DanielFLopez1620/orion_common/README.md

# 🤖 ORION Commons

## 🌟 Overview

orion_welcome

This repository contains essential packages for the **O**pen-source **R**obot for **I**nteraction **O**bjectives and **N**avigation, also known as **ORION Project**, a ROS 2-based differential mobile robot designed for **Human-Robot Interaction (HRI)** applications.

**Keywords:** ROS 2, Differential Robot, HRI, ROS 2 Jazzy, Low-Cost Robotics.

> Note: This is a fork of the original version, which aims to check for updates as some time has passed by and also work on some pending bugs or functionalities. This may depend on my free time, so not sure how frequent the changes would be.

---

## 📝 License

The source code is released under a [BSD 3-Clause license](/LICENSE).

**Forked and maintained by:** [Daniel Felipe López Escobar](https://github.com/DanielFLopez1620)

**Originally developed by**: [Daniel Felipe López Escobar](https://github.com/DanielFLopez1620), [Miguel Ángel Gonzalez Rodriguez](https://github.com/miguelgonrod), and [Alejandro Bermúdez Fajardo](https://github.com/alexoberco).

The ORION Commons packages have been tested under [ROS](https://www.ros.org/) **Jazzy** distribution.

---

## 📚 Table of Contents

- [📦 Repository Summary](#-repository-summary)
- [🧩 Other Functionalities](#-other-functionalities)
- [📥 Installation](#-installation)
- [⚠️ Troubleshooting](#️-troubleshooting)

---

## 📦 Repository Summary

The repository is organized into modular ROS 2 packages:

- 🌌 **[`orion`](/orion/README.md)** 🛰️ Meta-package grouping all main components dependencies.
- 📦 **[`orion_assets`](/orion_assets/README.md)** 🗂️ CAD files for design, assembly, and construction of the robot.
- 🎮 **[`orion_control`](/orion_control/README.md)** 🧠 Configuration for controllers and hardware interfaces plugins for ROS 2 controllers.
- 🧩 **[`orion_description`](/orion_description/README.md)** 📐 URDF/Xacro description of the robot’s structure.
- 🏗️ **[`orion_base`](/orion_base/README.md)** 📦 Core logic and embedded codes of the ESP32s (mobile base and interaction) of the robot.
- 🚀 **[`orion_bringup`](/orion_bringup/README.md)** 🟢 Launch and startup configuration for the usage of the real robot.
- 🐳 **[`orion_docker`](/orion_docker/README.md)** 📦 Docker support for containerized development and deployment of the robot.
- 🧰 **[`orion_utils_py`](/orion_utils_py/README.md)** 🐍 Utility scripts in Python 3 to common applications like laser filter or simple actions.

To build you robot, review the hardware changes and learn about the versions of the robot, do not forget to check the 📖 [`ORION Wiki`](https://github.com/DanielFLopez1620/orion_common/wiki) 📔

---

## 🧩 Other Functionalities

These components provide extended capabilities for sensors, simulation, perception, and interaction:

- 🧿 **[`orion_gz`](https://github.com/Tesis-ORION/orion_gz)** 🏙️ Simulation of the robot in GZ Harmonic that integrates native plugins, bridges between ROS 2 and GZ with [`ros_gz_bridge`](https://github.com/gazebosim/ros_gz/tree/ros2/ros_gz_bridge), and the integration of [`ros2_control`](https://control.ros.org/) with [`gz_ros2_control`](https://github.com/ros-controls/gz_ros2_control).

- 📄 **[`orion_tools`](https://github.com/DanielFLopez1620/orion_tools)** 🔧 A collection of packages for using SLAM, Nav2 and teleoperation with the robot.

- 🌐 **[`orion_web_interface`](https://github.com/Tesis-ORION/orion_web_interface)** 🖥️ Tool that allows the control and visualization of the robot by using a [`Node.js`](https://nodejs.org/en) and [`Astro`](https://astro.build/) Web interface.

- 🎥 **[`depth_orbbec_astra`](https://github.com/Tesis-ORION/depth_orbbec_astra)** 🔵 Packages to use the ORBBEC Astra RGBD Cameras on ROS 2 Jazzy. In this project is used the [ASTRA S](https://store.orbbec.com/products/astra-s) model.

- 🎥 **[`depth_ydlidar_os30a`](https://github.com/Tesis-ORION/Depth_ydlidar_os30a)** 🔴 Package to use the [YDLIDAR OS30A](https://www.ydlidar.com/products/view/23.html) on ROS 2 Jazzy.

- 🎥 **[`depth_maixsense_a010`](https://github.com/DanielFLopez1620/depth_maixsense_a010)** 🟢 Packages for the [Maixsense A010 Depth Camera](https://wiki.sipeed.com/hardware/en/maixsense/maixsense-a010/maixsense-a010.html) to work on ROS 2 Jazzy.

---

## 📥 Installation

Let's prepare us to use the robot, this installation is required for both your PC and the robot's Raspberry Pi. However, there would be additional steps you will need to follow on the robot, more info on [orion_bringup](/orion_bringup/README.md)

For now, follow these steps to install and build the project on ROS 2 Jazzy:

0. Make sure you have `colcon` installed:

    ~~~bash
    sudo apt update
    sudo apt install python3-colcon-common-extensions -y
    ~~~

1. Create your workspace:

    ~~~bash
    mkdir -p ~/ros2_ws/src
    cd ~/ros2_ws
    colcon build
    ~~~

2. Install the repository of ORION common in the source directory

    ~~~bash
    cd ~/ros2_ws/src
    git clone https://github.com/DanielFLopez1620/orion_common.git
    ~~~

3. Install the drivers packages for the cameras and the LD19 LIDAR.

    ~~~bash
    cd ~/ros2_ws/src
    git clone https://github.com/DanielFLopez1620/depth_maixsense_a010.git
    git clone https://github.com/Tesis-ORION/Depth_ydlidar_os30a.git
    git clone https://github.com/Tesis-ORION/depth_orbbec_astra.git

    # LD19 LIDAR driver — use main branch only (no per-distro branches exist).
    # The SDK is a git submodule, so --recurse-submodules is required.
    git clone --branch main --recurse-submodules \
        https://github.com/Myzhar/ldrobot-lidar-ros2.git
    ~~~

4. Implement the additional installs recommended on the cameras READMEs, for more info check [Maixsense A010](https://github.com/DanielFLopez1620/depth_maixsense_a010), [YDLidar OS30A](https://github.com/Tesis-ORION/Depth_ydlidar_os30a) and [ORBBEC ASTRA S](https://github.com/Tesis-ORION/depth_orbbec_astra) packages.

    ~~~bash
    # --------- General
    sudo usermod -a -G dialout $USER

    # -------- OS30A
    sudo ln -sf /lib/x86_64-linux-gnu/libdc1394.so /usr/lib/libdc1394.so.22

    # --------- ASTRA S
    sudo apt install libgflags-dev nlohmann-json3-dev  \
    ros-$ROS_DISTRO-image-transport  ros-${ROS_DISTRO}-image-transport-plugins ros-${ROS_DISTRO}-compressed-image-transport \
    ros-$ROS_DISTRO-image-publisher ros-$ROS_DISTRO-camera-info-manager \
    ros-$ROS_DISTRO-diagnostic-updater ros-$ROS_DISTRO-diagnostic-msgs ros-$ROS_DISTRO-statistics-msgs \
    ros-$ROS_DISTRO-backward-ros libdw-dev
    ~~~

5. Install all the dependencies:

    ~~~bash
    sudo apt update
    sudo apt install python3-rosdep -y
    cd ~/ros2_ws
    sudo rosdep init
    rosdep update
    rosdep install --from-paths src --ignore-src -r -y
    ~~~

6. After the installation is complete, build the package with the provided options to avoid errors with other packages in development:

    ~~~bash
    cd ~/ros2_ws
    colcon build --symlink-install --packages-select orion orion_description orion_control
    source install/setup.bash
    ~~~

7. You are ready to explore the usage of the robot on this PC, now proceed with the robot [bringup](/orion_bringup/README.md)

---

## ⚠️ Troubleshooting

Explore the different packages to check solutions to common problems found during the development of the project, considering the next:

- **orion_base:** Cases in terms of the embedded codes of the ESP32, µ-ROS, electronic connections and hardware specifications.
- **orion_bringup:** In terms of the startup application of the robot and the bringup of the robot.
- **orion_control:** For problems related with the plugins for the hardware interfaces of the controllers and general params of the controllers.
- **orion_description:** Cases related with the description model, changes of macros and params of actuators/controllers.

If you present another problem, propose it on the **[Issues](https://github.com/DanielFLopez1620/orion_common/issues)** of this repository.

---
