DanielFLopez1620/orion_common/orion/README.md

# 🤖 ORION

## 🖼️ Meet ORION

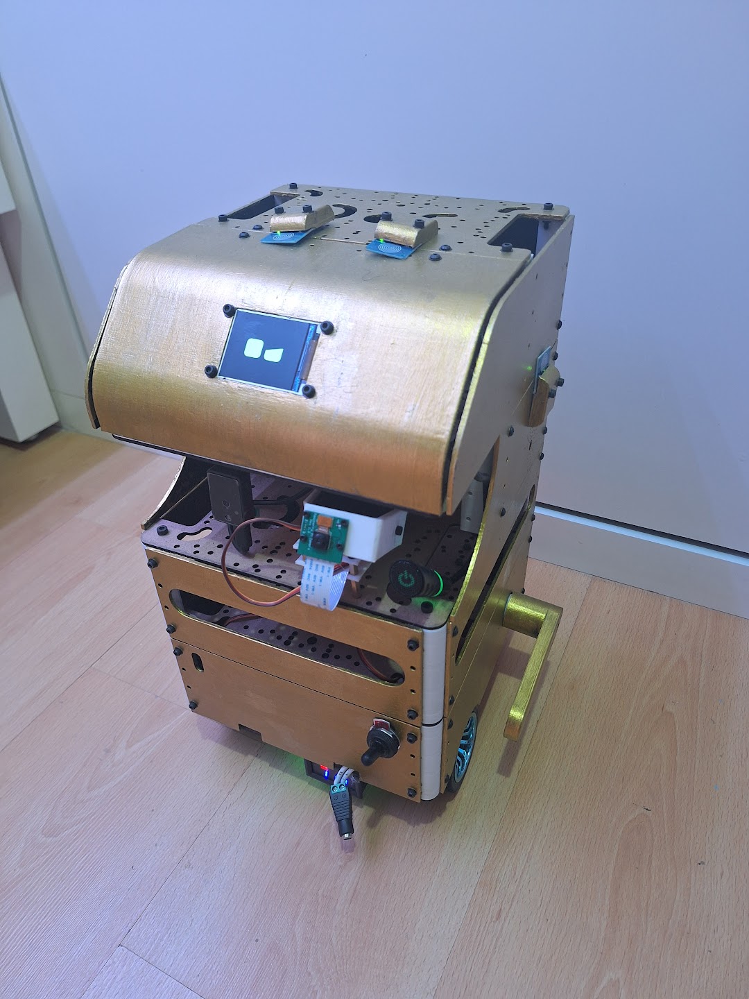
[picture p1: orion/img/orion_is_here.jpg]
orion_is_here


## 🌟 Overview

Meta-package that aggregates all core **ORION Common** packages — the **O**pen-source **R**obot for **I**nteraction **O**bjectives and **N**avigation. ROS 2 Jazzy differential robot designed for Human-Robot Interaction (HRI) applications.

---

## 📚 Table of Contents

- [📦 Core Packages](#-core-packages)
- [🚀 Quick Start](#-quick-start)
- [📖 Documentation](#-documentation)
- [🖼️ Meet ORION](#️-meet-orion)

---

## 📦 Core Packages

This meta-package ensures all dependencies are available:

- **[orion_description](/orion_description/README.md)** — URDF/Xacro robot model, mesh files, and description launch files
- **[orion_control](/orion_control/README.md)** — ROS 2 controllers and hardware interfaces (DiffDrive, Forward Command)
- **[orion_bringup](/orion_bringup/README.md)** — Startup configurations, udev rules, and systemd service
- **[orion_base](/orion_base/README.md)** — ESP32 embedded firmware (micro-ROS and serial implementations)
- **[orion_utils_cpp](/orion_utils_cpp/README.md)** — CPP utility codes (demos, laser filter, emotion display)
- **[orion_utils_py](/orion_utils_py/README.md)** — Python utility scripts (demos, laser filter, emotion display, g_mov module and related scripts)
- **[orion_assets](/orion_assets/README.md)** — CAD files, STL meshes, and fabrication resources
- **[orion_docker](/orion_docker/README.md)** — Containerized development and deployment environments

---

## 🚀 Quick Start

1. **Installation:** Follow the main [README](/README.md) for setup instructions.
2. **Hardware:** Check the [Wiki](https://github.com/DanielFLopez1620/orion_common/wiki) for robot construction and schematics.
3. **Examples:** See [orion_utils_py](/orion_utils_py/README.md) for demo scripts.

---

## 📖 Documentation

- **[Main README](/README.md)** — Full installation and troubleshooting guide
- **[CONTRIBUTING.md](/CONTRIBUTING.md)** — Code standards, branch naming, and PR guidelines
- **[Wiki](https://github.com/DanielFLopez1620/orion_common/wiki)** — Hardware, assembly, and detailed tutorials

---
