DanielFLopez1620/orion_common/orion_assets/README.md

# 🤖 ORION Assets

## 🌟 Overview

This directory contains the related files for the design, manufacturing and fabrication of the ORION robot.
If you want to build the robot, check the ⚙️[`Robot Construction`](https://github.com/Tesis-ORION/orion_common/wiki/Building-your-own-ORION-robot)🔧 on the Wiki.

---

## 📝 License

The CAD files (referred to the FreeCAD assets, meshes and drawings) are released under the Creative Commons Attribution-NonCommercial 4.0 International ([CC BY-NC 4.0](/orion_assets/LICENSE))

**Maintainer**: [Daniel Felipe López Escobar](https://github.com/DanielFLopez1620).

---

## Content

You can find the next information and files:

- **[3DPrintAssets:](/orion_assets/3DPrintAssets/README.md)** It is a collection of assets in STL so you can pass the files to your slicer and start building the ORION robot.

- **[FreeCadAssets:](/orion_assets/FreeCadAssets/README.md)** They are the source CAD of the project, so if you want to make modifications or take a look of the pieces you can do it freely by using *FreeCad 1.0.0*.

- **[laserAssets:](/orion_assets/LasserAssets/README.md)** Another option to create some parts of ORION is by using laser cuts on MDF, acrylic or similar materials. This only applies to bases and walls.

- **[calc_inertia.py:](/orion_assets/calc_inertia.py)** It is a file oriented to obtain the inertia of STL and URDF by providing the object path, the scale and the mass.
