DanielFLopez1620/orion_common/orion_assets/LasserAssets/README.md

# Laser Assets

This directory contains the drawing files for the parts intended to be cut with Laser. They were exported by using **FreeCAD**.

## Preparations

To build your ORION robot, you can cut the pieces over acrylic, MDF or similar materials with a thickness between 3 mm to 6 mm, depending on the material and the endurance you want. You require an area of material between 1 m² to 1.5 m².

The .dxf extension files were provided as they are the most common ones that are asked when going to a workshop to cut pieces. If your require other formats, please refer to **[FreeCadAssets](/orion_assets/FreeCadAssets/README.md)**, search the pieces you need and convert them to the desired format.

### Required pieces to build ORION 1.3.x to 1.6.x

You will require the next pieces:

| Name | Quantity | Info |
|---|---|---|
| [Battery Holder Support](/orion_assets/LasserAssets/bathold_support.dxf)  | 2 | To mount the battery holders |
| [Complete Platform](/orion_assets/LasserAssets/com_plate_template.dxf) | 4 | Complete level structure of the robot |
| [Half Platform](/orion_assets/LasserAssets/half_plate_template.dxf) | 2 | Half level structure of the robot |
| [Wall Batteries](/orion_assets/LasserAssets/wall_batteries.dxf) | 1 | Front wall that allows charger and switch placement |
| [Wall Curve Speaker](/orion_assets/LasserAssets/wall_curve_speaker.dxf) | 2 | Curve wall when using RPi4 Speakers |
| [Wall Curve](/orion_assets/LasserAssets/wall_curve.dxf) | 2 | Curve wall when using RPi5 |
| [Wall Front Lidar](/orion_assets/LasserAssets/wall_flidar.dxf) | 2 | Front/back wall for LIDAR scanning space |
| [Wall Lateral Lidar](/orion_assets/LasserAssets/wall_llidar.dxf) | 2 | Lateral walls for LIDAR scanning space |
| [Wall Regulator](/orion_assets/LasserAssets/wall_regulator.dxf) | 1 | Back wall that allows check of the regulator |
| [Wall Raspberry Pi](/orion_assets/LasserAssets/wall_rpi.dxf) | 1 | Back wall for RPi HMDIs and aux connections |
| [Wall Screen](/orion_assets/LasserAssets/wall_screen.dxf) | 2 | Wall that allow the form of the screen |
| [Wall Servo](/orion_assets/LasserAssets/wall_servo.dxf) | 2 | Lateral wall where the arms are placed |
| [Wall Stereo](/orion_assets/LasserAssets/wall_stereo.dxf) | 1 | Back wall when using RPi5 speaker |
