DanielFLopez1620/orion_common/orion_assets/FreeCadAssets/assembly_orion_full.FCStd

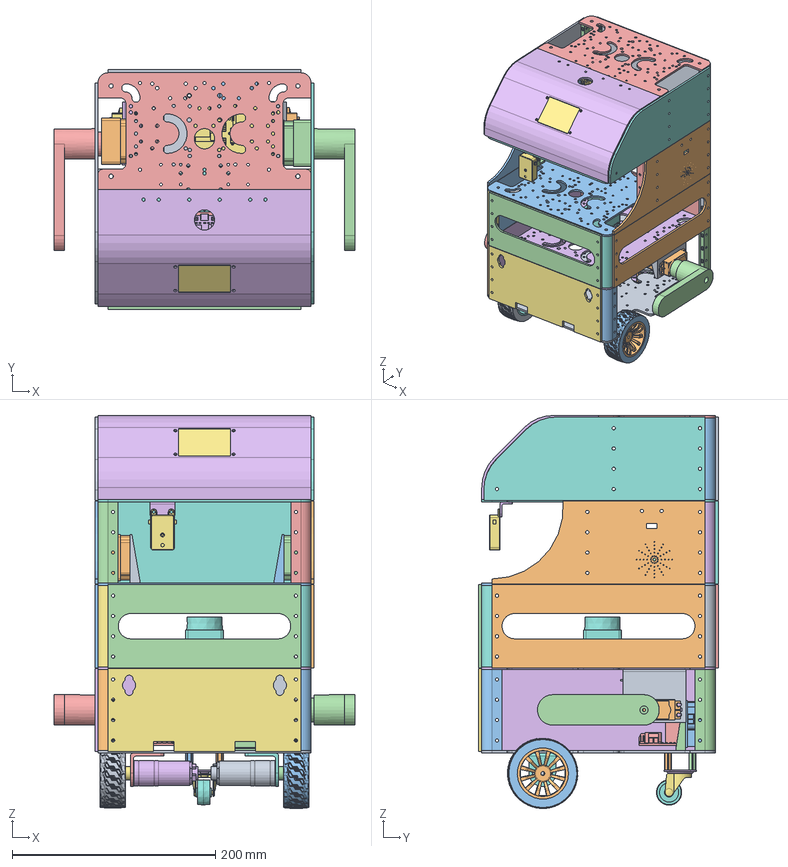
[picture p4: CAD file, 2026-07-29]
orion_assets/FreeCadAssets/assembly_orion_full.FCStd
296.0 x 236.0 x 387.1 mm
com_plate_template_com_plate_template_001
spacer_10x80_Body_001
spacer_10x80_Body_002
spacer_10x80_Body_003
spacer_10x80_Body_004
com_plate_template_com_plate_template_002
spacer_10x80_Body_005
spacer_10x80_Body_006
spacer_10x80_Body_007
spacer_10x80_Body_008
com_plate_template_com_plate_template_003
spacer_10x80_Body_009
spacer_10x80_Body_010
spacer_10x80_Body_011
spacer_10x80_Body_012
com_plate_template_com_plate_template_004
spacer_10x80_Body_013
spacer_10x80_Body_014
spacer_10x80_Body_015
spacer_10x80_Body_016
com_plate_template_half_plate_template001_001
screen_support_ScreenSupport_001
screen_il9225_screen_il9225_001
wall_lateral_template_wall_screen_001
wall_lateral_template_wall_screen_002
wall_lateral_template_wall_llidar_001
wall_lateral_template_wall_llidar_002
wall_frontal_template_wall_flidar_001
wall_frontal_template_wall_flidar_002
wall_lateral_template_wall_servo_002
wall_frontal_template_wall_batteries_001
wall_frontal_template_wall_fdefault_001
wall_frontal_template_wall_raspberry_001
wall_lateral_template_wall_curve_speaker_001
wall_lateral_template_wall_curve_speaker_002
simple_arm_simple_arm_001
simple_arm_simple_arm_002
maixsense_support_maixsense_sup_001
sipeed_a010_MaixsensA010_001
motor_mount_MotorMount_001
dc_motor_wenc_MotorDCwEnc_001
ring_Ring_001
neumatic_Neumatic_001
coupling_Coupling_001
motor_mount_MotorMount_002
dc_motor_wenc_MotorDCwEnc_002
coupling_Coupling_002
ring_Ring_002
neumatic_Neumatic_002
spacer_m4x17_spacer_m4x17_001
spacer_m4x17_spacer_m4x17_002
spacer_m4x17_spacer_m4x17_003
spacer_m4x17_spacer_m4x17_004
caster_wheel_p1_CasterBase_001
caster_wheel_p2_CasterWheelP2_001
caster_wheel_p3_CasterWheelP3_001
speaker_support_speaker_support_001
mini_speaker_mini_speaker_001
speaker_support_speaker_support_002
mini_speaker_mini_speaker_002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
