DanielFLopez1620/orion_common/orion_assets/FreeCadAssets/regulator.FCStd

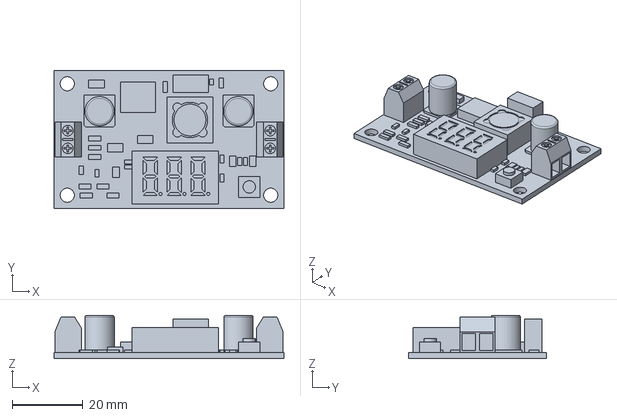
[picture p7: CAD file, 2026-07-29]
orion_assets/FreeCadAssets/regulator.FCStd
65.0 x 39.0 x 12.2 mm
