DanielFLopez1620/orion_common/orion_assets/LasserAssets/wall_screen.dxf

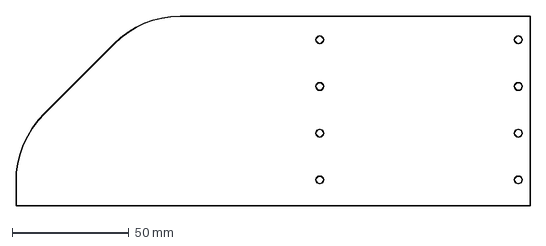
[picture p8: CAD file, 2025-11-06]
orion_assets/LasserAssets/wall_screen.dxf
220.0 x 81.0 mm
