DanielFLopez1620/orion_common/orion_description/meshes/picam_sup.stl

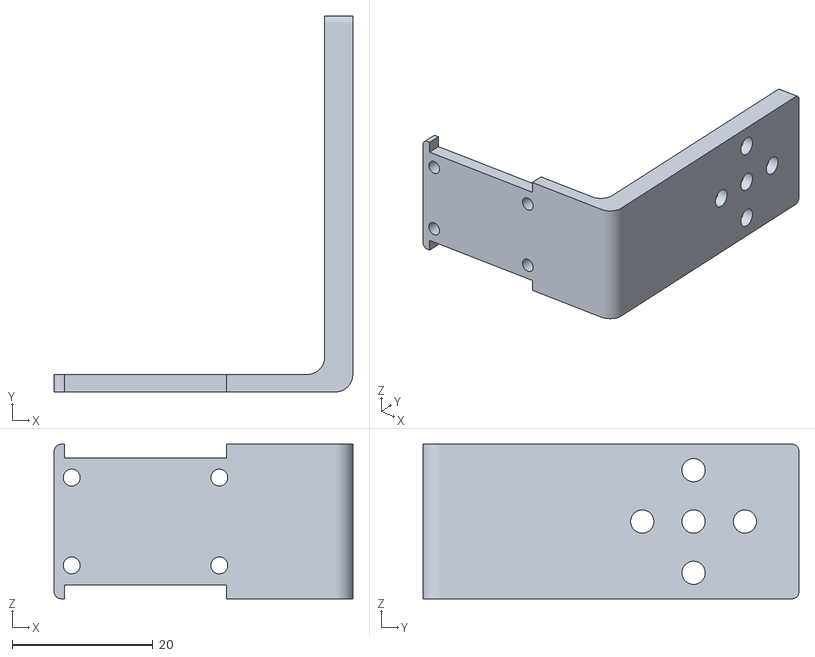
[picture p9: CAD file, 2026-07-29]
orion_description/meshes/picam_sup.stl
42.5 x 53.5 x 22.0
