DanielFLopez1620/orion_common/orion_assets/3DPrintAssets/orion_toy_cuboid.stl

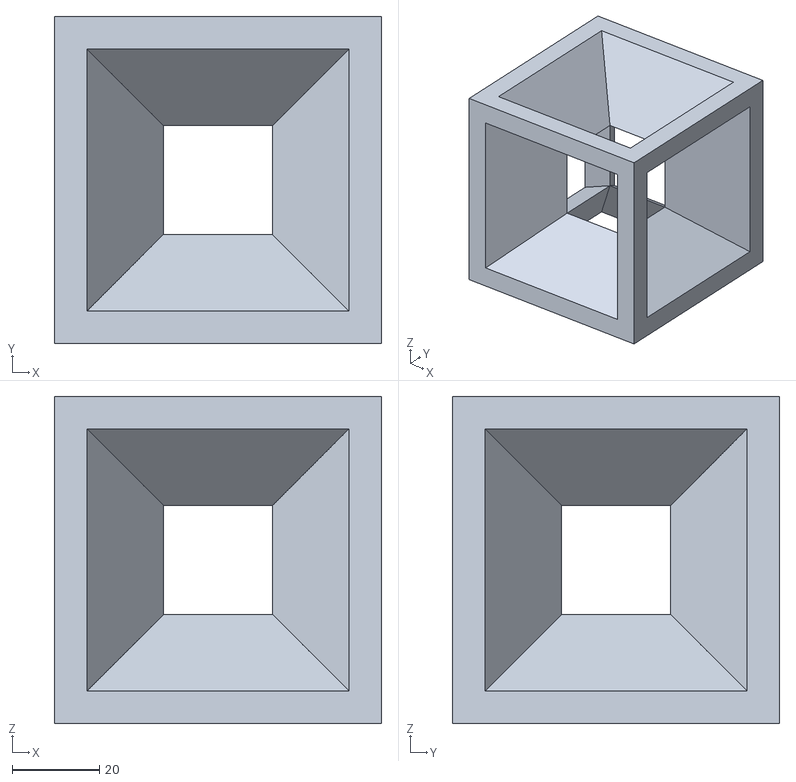
[picture p10: CAD file, 2025-11-06]
orion_assets/3DPrintAssets/orion_toy_cuboid.stl
75.0 x 75.0 x 75.0
