DanielFLopez1620/orion_common/orion_assets/FreeCadAssets/spacer_m3x10.FCStd

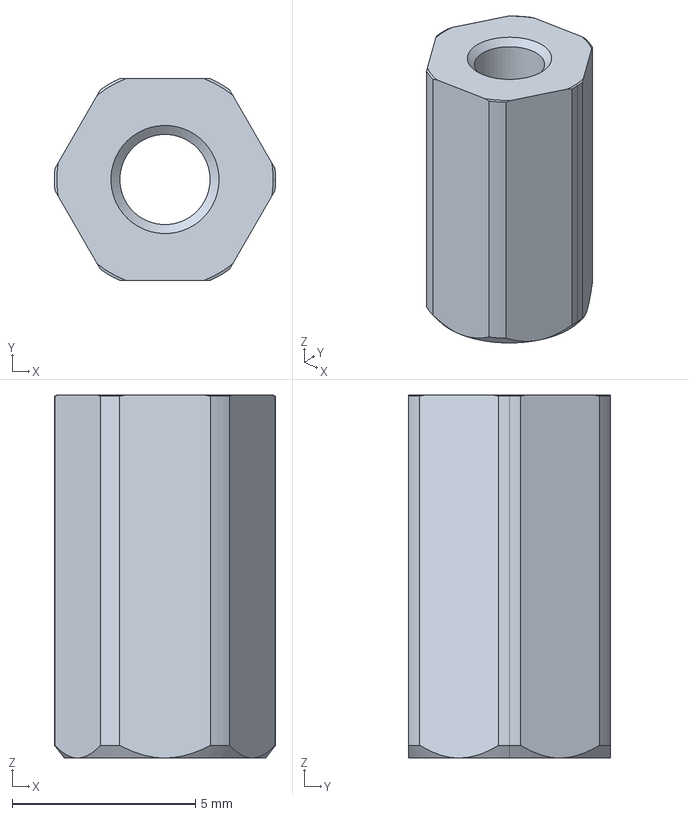
[picture p11: CAD file, 2026-07-29]
orion_assets/FreeCadAssets/spacer_m3x10.FCStd
6.03 x 5.50 x 9.90 mm
