DanielFLopez1620/orion_common/orion_assets/LasserAssets/wall_stereo.dxf

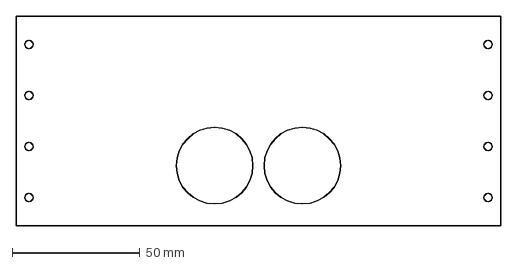
[picture p12: CAD file, 2025-11-06]
orion_assets/LasserAssets/wall_stereo.dxf
190.0 x 82.0 mm
