DanielFLopez1620/orion_common/orion_description/meshes/accel.stl

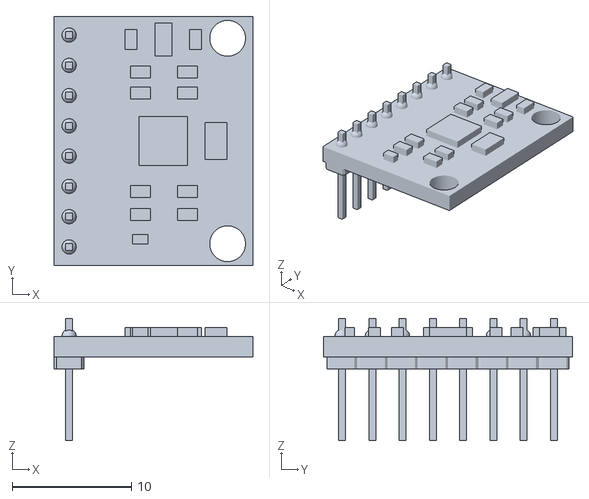
[picture p13: CAD file, 2026-07-29]
orion_description/meshes/accel.stl
16.7 x 20.9 x 10.2
