DanielFLopez1620/orion_common/orion_assets/FreeCadAssets/caster_wheel_p2.FCStd

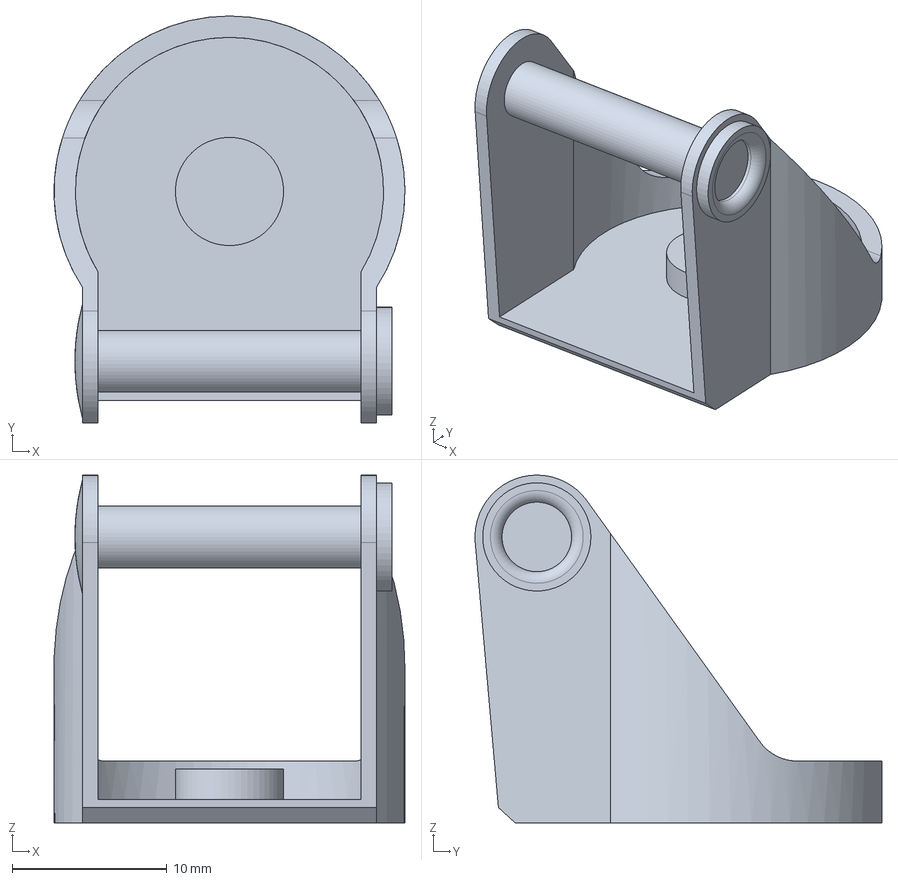
[picture p15: CAD file, 2026-07-29]
orion_assets/FreeCadAssets/caster_wheel_p2.FCStd
22.7 x 26.3 x 22.5 mm
