DanielFLopez1620/orion_common/orion_assets/3DPrintAssets/screen_support_h1.stl

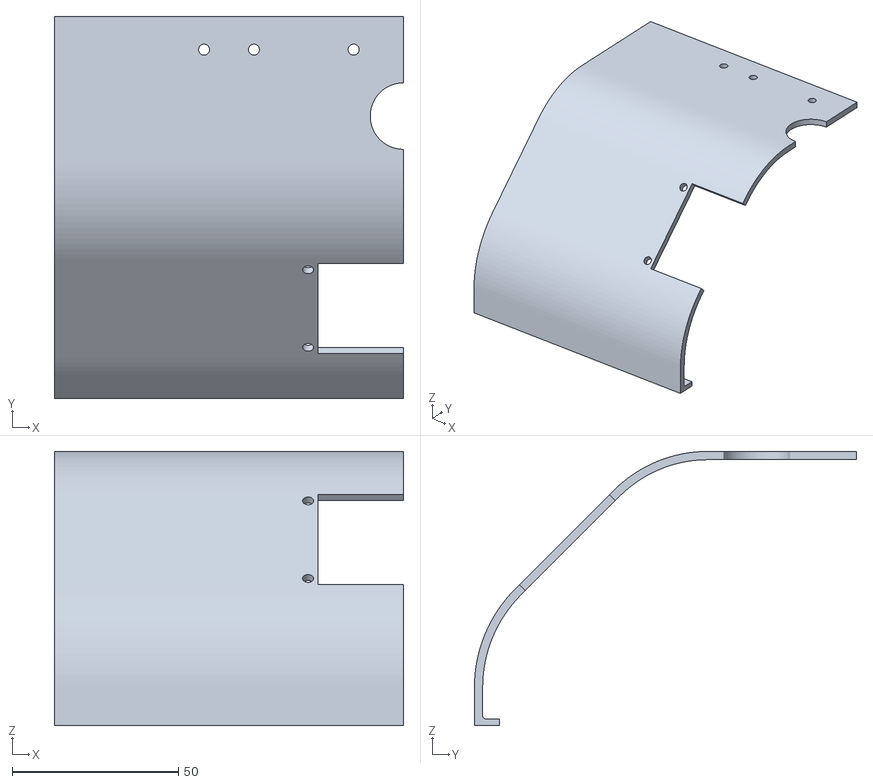
[picture p18: CAD file, 2025-11-06]
orion_assets/3DPrintAssets/screen_support_h1.stl
105.0 x 115.0 x 82.5
