DanielFLopez1620/orion_common/orion_assets/FreeCadAssets/joint_plates_m3.FCStd

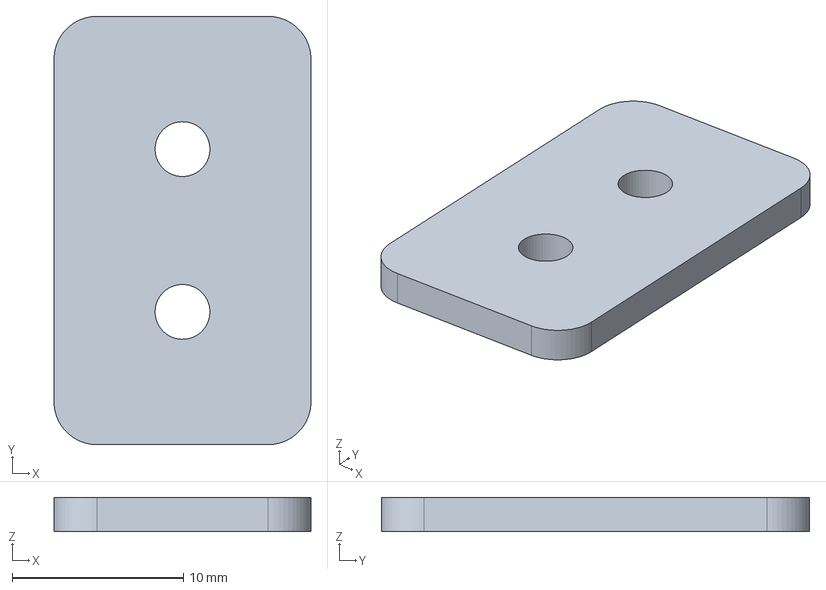
[picture p19: CAD file, 2026-07-29]
orion_assets/FreeCadAssets/joint_plates_m3.FCStd
15.0 x 25.0 x 2.00 mm
