DanielFLopez1620/orion_common/orion_assets/LasserAssets/wall_rpi.dxf

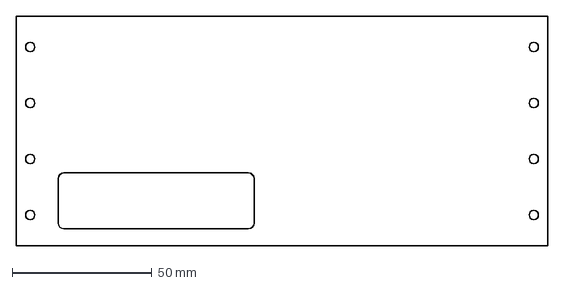
[picture p20: CAD file, 2025-11-06]
orion_assets/LasserAssets/wall_rpi.dxf
190.0 x 82.0 mm
