DanielFLopez1620/orion_common/orion_description/meshes/accel_base.stl

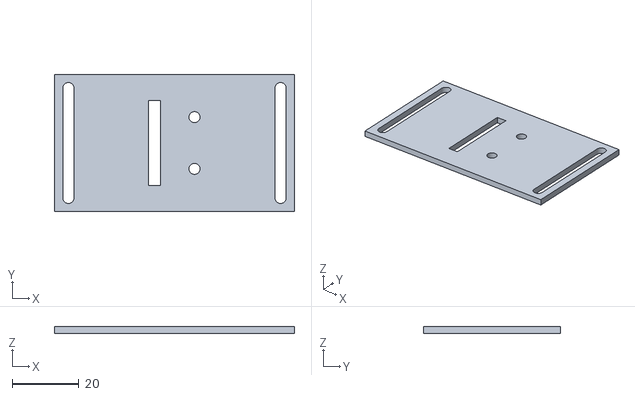
[picture p21: CAD file, 2026-07-29]
orion_description/meshes/accel_base.stl
72.0 x 41.0 x 2.00
