DanielFLopez1620/orion_common/orion_assets/3DPrintAssets/com_plate.stl

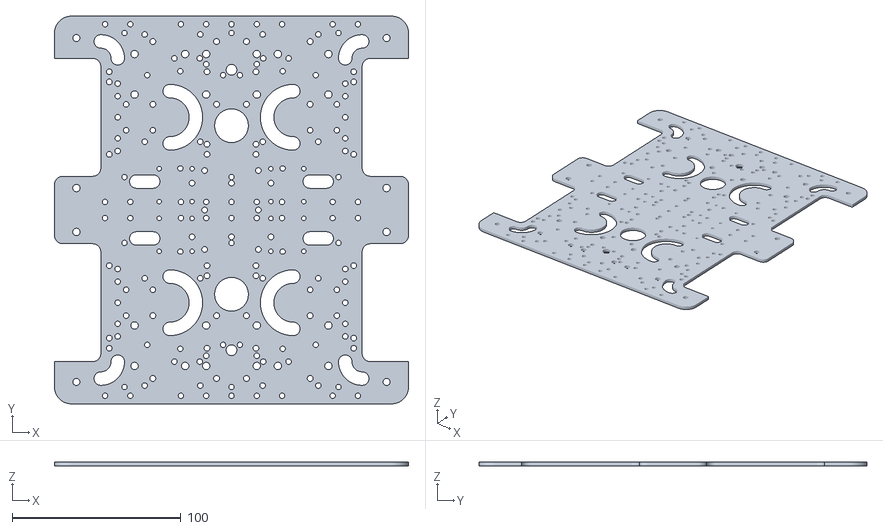
[picture p22: CAD file, 2025-11-06]
orion_assets/3DPrintAssets/com_plate.stl
210.0 x 230.0 x 2.50
