DanielFLopez1620/orion_common/orion_assets/FreeCadAssets/speaker_stereo.FCStd

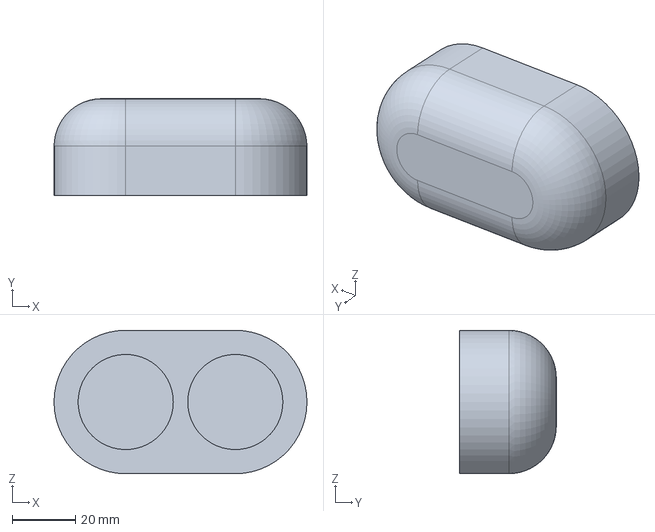
[picture p23: CAD file, 2026-07-29]
orion_assets/FreeCadAssets/speaker_stereo.FCStd
79.8 x 30.5 x 45.2 mm
