DanielFLopez1620/orion_common/orion_description/meshes/servo_base.stl

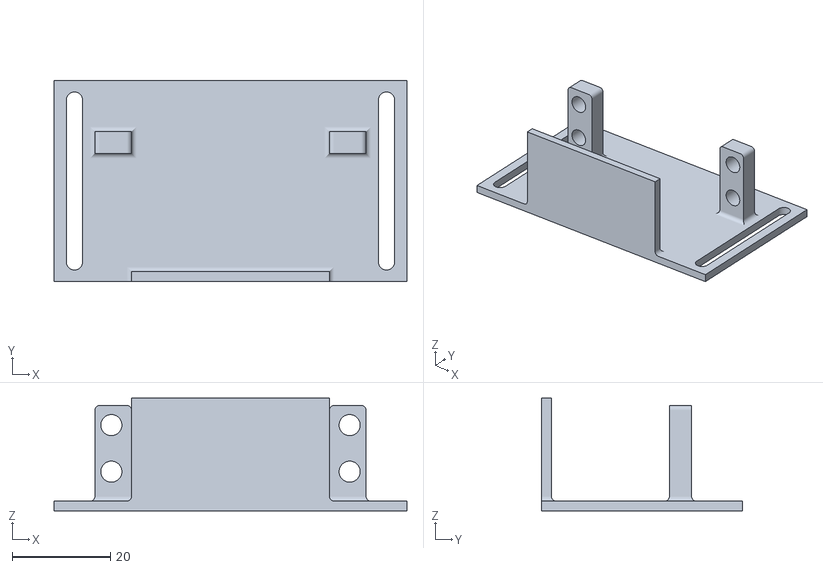
[picture p25: CAD file, 2026-07-29]
orion_description/meshes/servo_base.stl
72.0 x 41.0 x 23.0
