DanielFLopez1620/orion_common/orion_assets/3DPrintAssets/touch_sensor_prot-touch_sensor_prot.stl

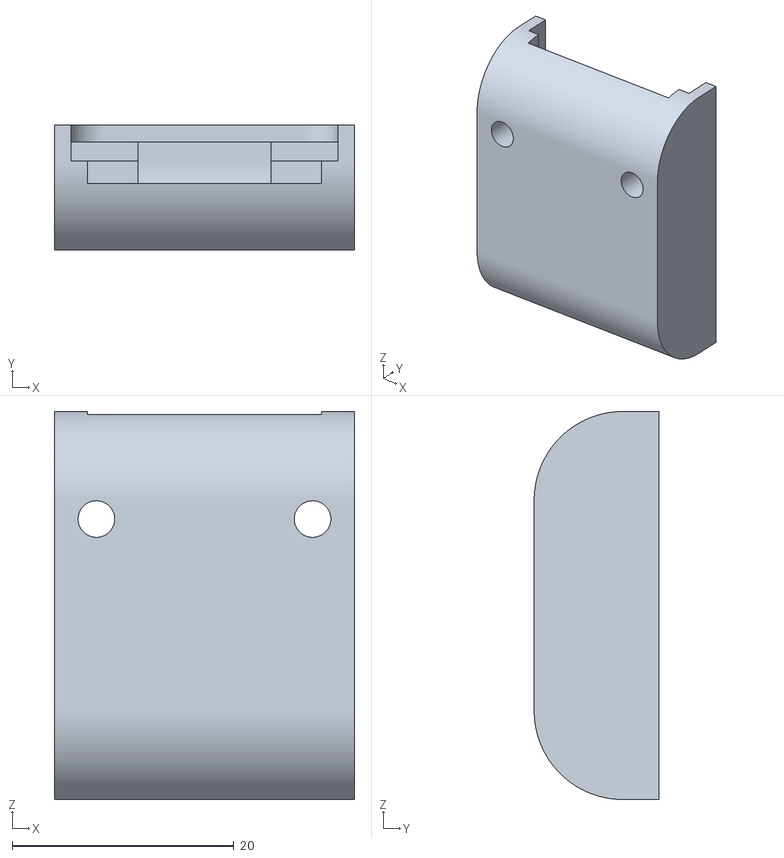
[picture p26: CAD file, 2025-11-06]
orion_assets/3DPrintAssets/touch_sensor_prot-touch_sensor_prot.stl
27.1 x 11.2 x 35.0
