DanielFLopez1620/orion_common/orion_assets/FreeCadAssets/servo_mg99.FCStd

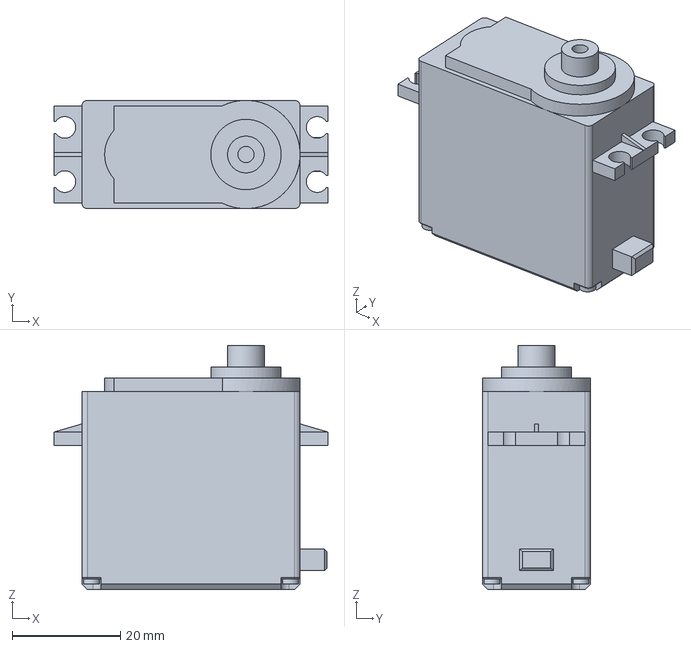
[picture p27: CAD file, 2026-07-29]
orion_assets/FreeCadAssets/servo_mg99.FCStd
50.6 x 20.0 x 45.1 mm
