DanielFLopez1620/orion_common/orion_description/meshes/picam.stl

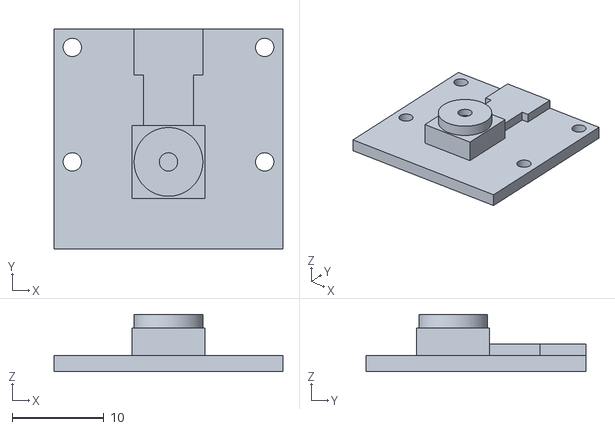
[picture p29: CAD file, 2026-07-29]
orion_description/meshes/picam.stl
25.0 x 24.0 x 6.25
