DanielFLopez1620/orion_common/orion_assets/3DPrintAssets/half_plate.stl

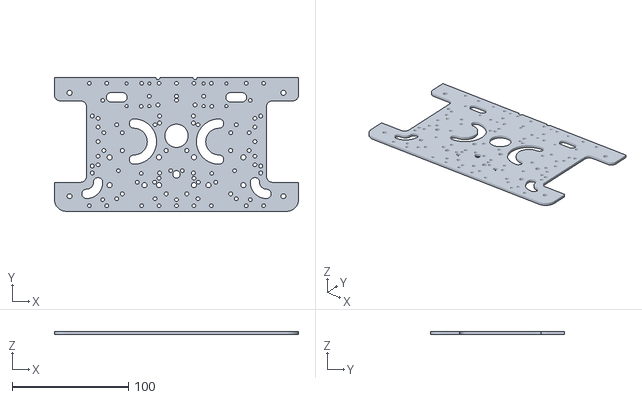
[picture p30: CAD file, 2025-11-06]
orion_assets/3DPrintAssets/half_plate.stl
210.0 x 115.0 x 2.50
