DanielFLopez1620/orion_common/orion_assets/FreeCadAssets/screen_il9225.FCStd

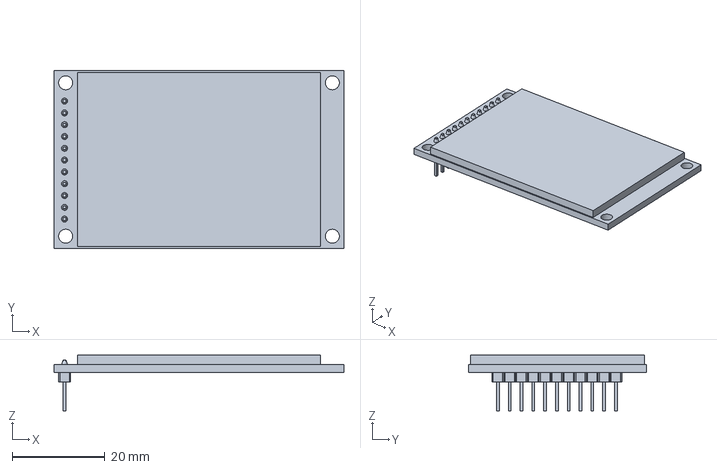
[picture p31: CAD file, 2026-07-29]
orion_assets/FreeCadAssets/screen_il9225.FCStd
62.4 x 38.2 x 12.0 mm
