DanielFLopez1620/orion_common/orion_assets/LasserAssets/wall_servo.dxf

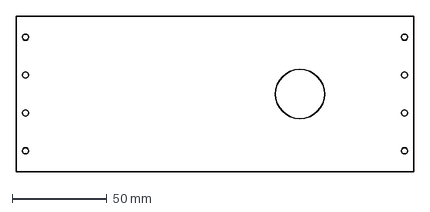
[picture p32: CAD file, 2025-11-06]
orion_assets/LasserAssets/wall_servo.dxf
210.0 x 82.0 mm
