DanielFLopez1620/orion_common/orion_description/meshes/spacer_m3x15.stl

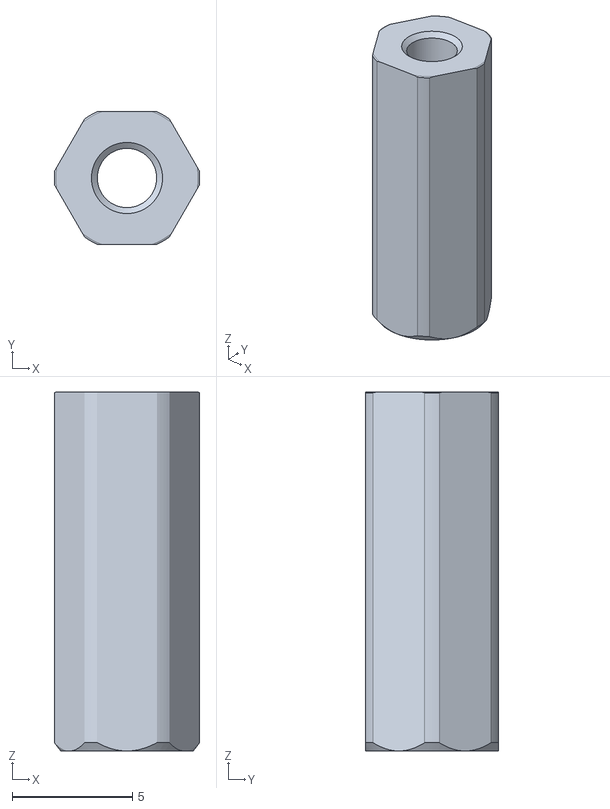
[picture p33: CAD file, 2026-07-29]
orion_description/meshes/spacer_m3x15.stl
6.03 x 5.50 x 14.9
