DanielFLopez1620/orion_common/orion_assets/FreeCadAssets/esp32.FCStd

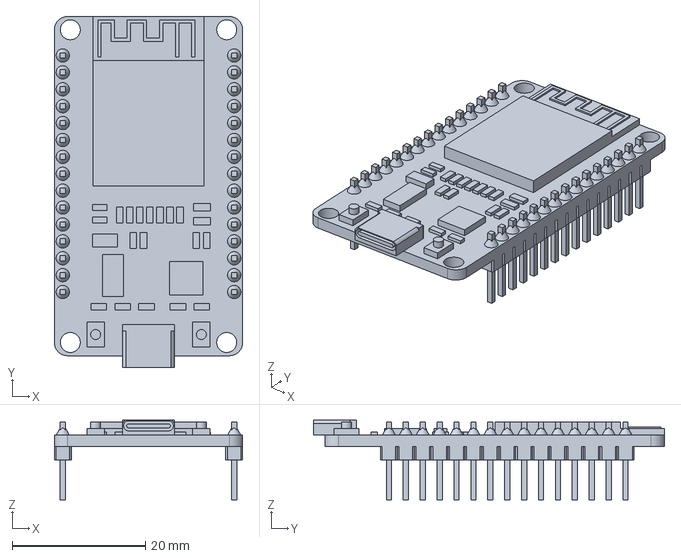
[picture p34: CAD file, 2026-07-29]
orion_assets/FreeCadAssets/esp32.FCStd
28.3 x 52.8 x 12.0 mm
