DanielFLopez1620/orion_common/orion_description/meshes/wall_curve_speaker.stl

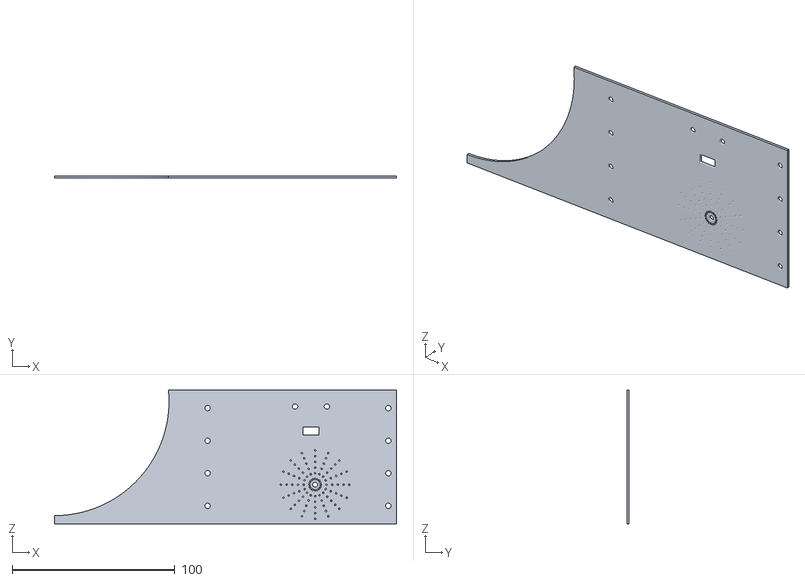
[picture p36: CAD file, 2025-11-06]
orion_description/meshes/wall_curve_speaker.stl
210.0 x 1.40 x 82.0
