DanielFLopez1620/orion_common/orion_assets/FreeCadAssets/servo_connection_ext.FCStd

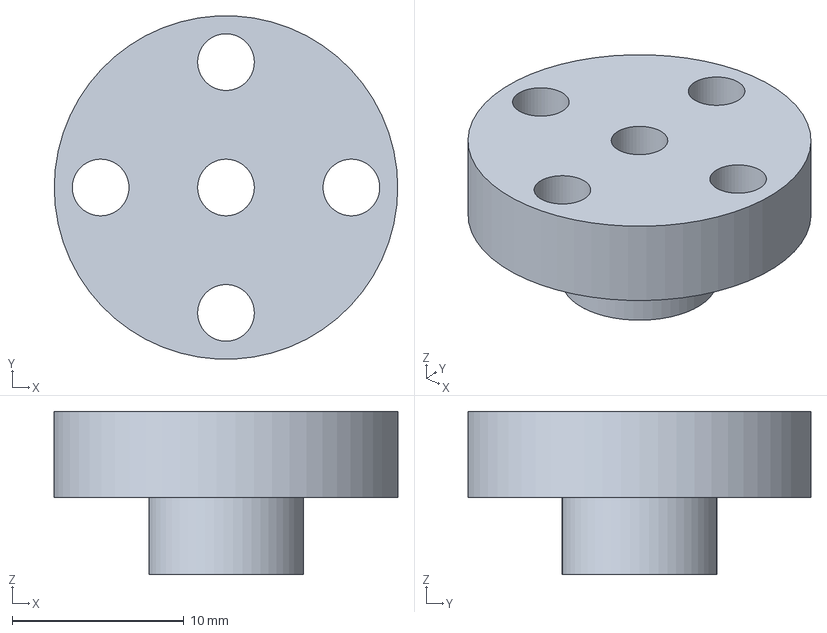
[picture p37: CAD file, 2026-07-29]
orion_assets/FreeCadAssets/servo_connection_ext.FCStd
20.0 x 20.0 x 9.50 mm
