DanielFLopez1620/orion_common/orion_assets/LasserAssets/bathold_support.dxf

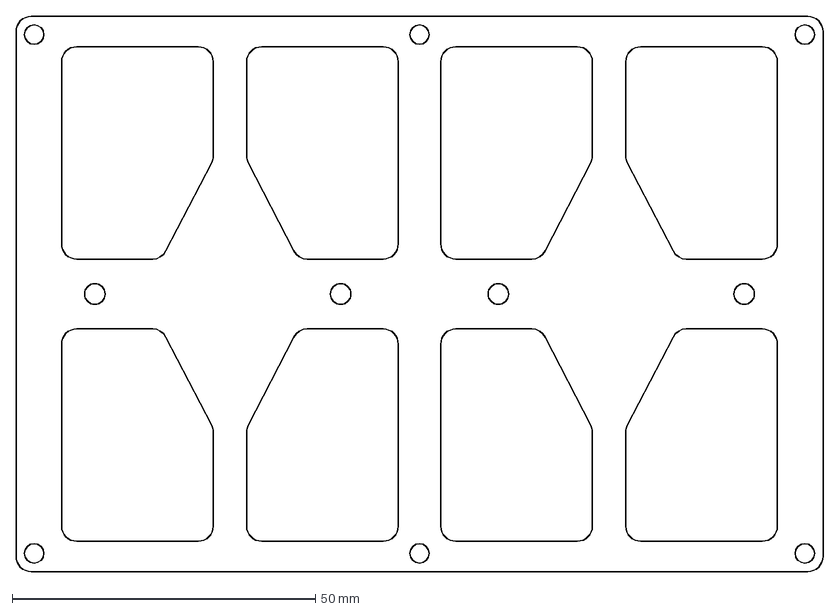
[picture p38: CAD file, 2025-11-06]
orion_assets/LasserAssets/bathold_support.dxf
133.0 x 91.5 mm
