DanielFLopez1620/orion_common/orion_description/meshes/speaker_sup.stl

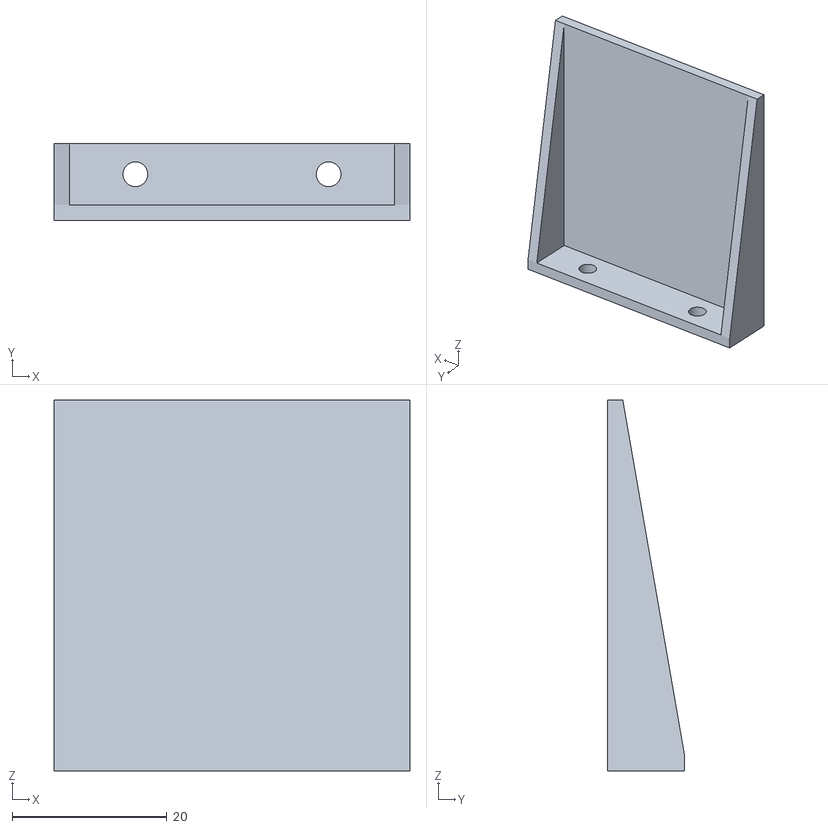
[picture p39: CAD file, 2025-11-06]
orion_description/meshes/speaker_sup.stl
46.0 x 10.0 x 48.0
