DanielFLopez1620/orion_common/orion_description/meshes/servo_conn.stl

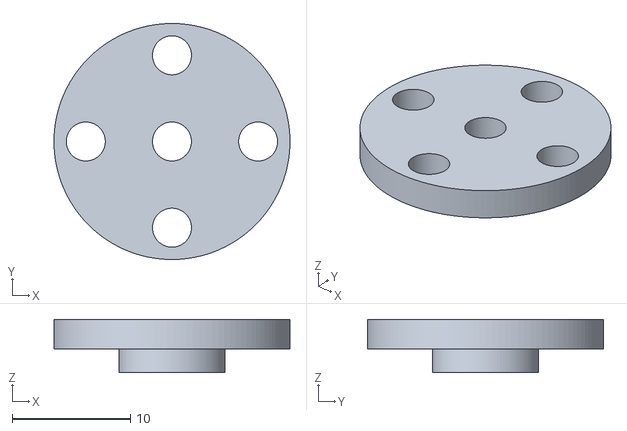
[picture p41: CAD file, 2025-11-06]
orion_description/meshes/servo_conn.stl
20.0 x 20.0 x 4.50
