DanielFLopez1620/orion_common/orion_assets/FreeCadAssets/switch_3s_15a.FCStd

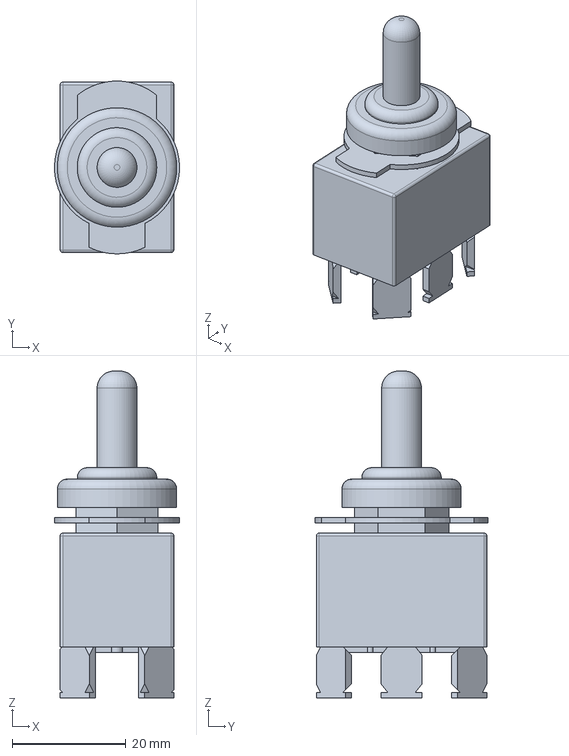
[picture p42: CAD file, 2026-07-29]
orion_assets/FreeCadAssets/switch_3s_15a.FCStd
22.0 x 30.4 x 57.5 mm
