DanielFLopez1620/orion_common/orion_assets/LasserAssets/wall_curve_speaker.dxf

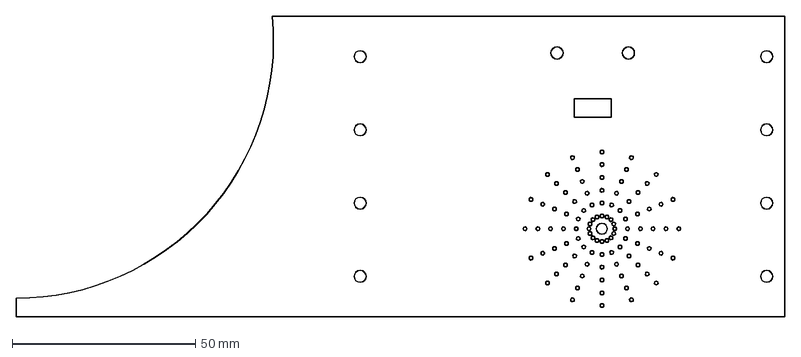
[picture p43: CAD file, 2025-11-06]
orion_assets/LasserAssets/wall_curve_speaker.dxf
210.0 x 82.0 mm
