DanielFLopez1620/orion_common/orion_description/meshes/batteryholderx3.stl

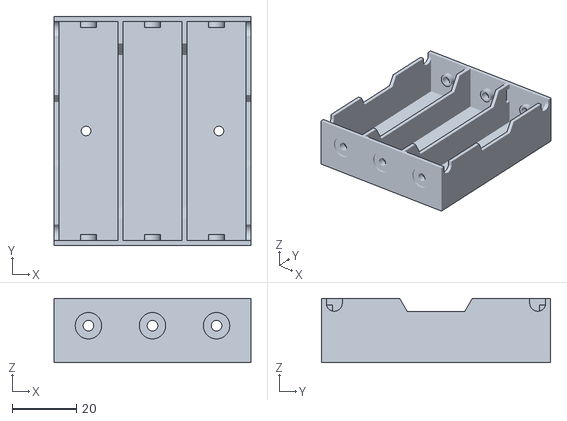
[picture p44: CAD file, 2025-11-06]
orion_description/meshes/batteryholderx3.stl
61.5 x 71.5 x 20.0
