DanielFLopez1620/orion_common/orion_assets/FreeCadAssets/support_os30a.FCStd

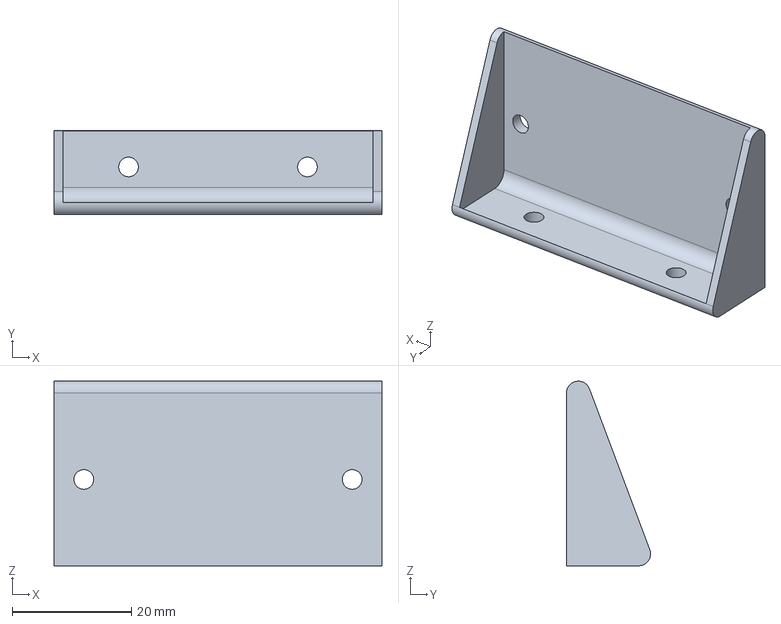
[picture p45: CAD file, 2026-07-29]
orion_assets/FreeCadAssets/support_os30a.FCStd
55.0 x 14.1 x 31.0 mm
