DanielFLopez1620/orion_common/orion_assets/LasserAssets/wall_regulator.dxf

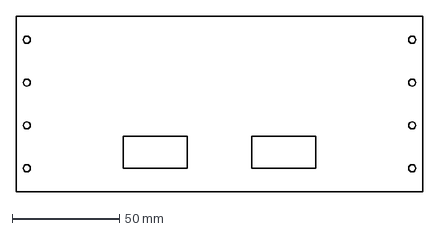
[picture p46: CAD file, 2025-11-06]
orion_assets/LasserAssets/wall_regulator.dxf
190.0 x 82.0 mm
