DanielFLopez1620/orion_common/orion_description/meshes/serial_ld.stl

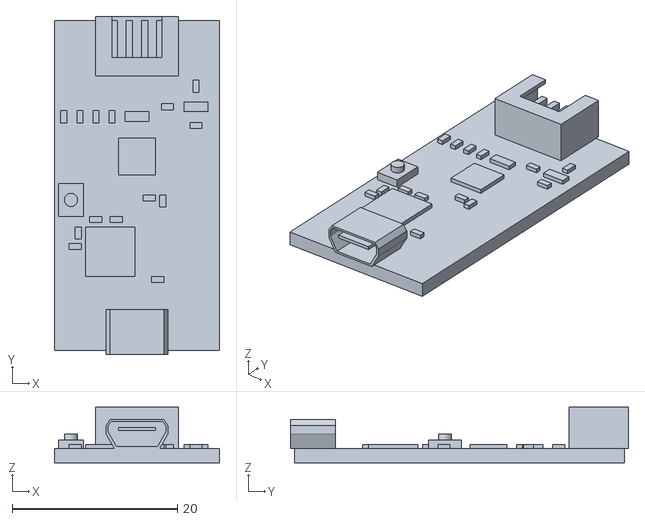
[picture p47: CAD file, 2025-11-06]
orion_description/meshes/serial_ld.stl
20.0 x 41.0 x 6.75
