DanielFLopez1620/orion_common/orion_assets/FreeCadAssets/wall_lateral_template.FCStd

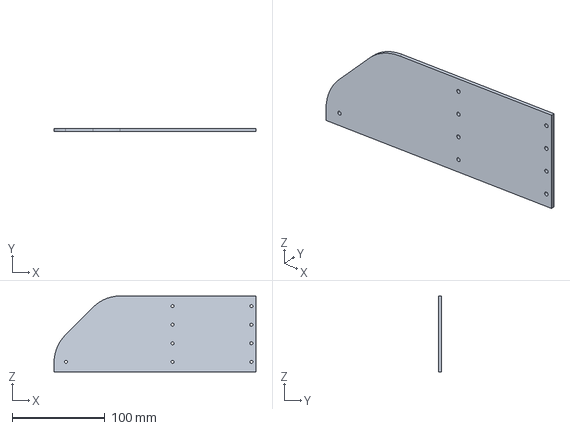
[picture p48: CAD file, 2026-07-29]
orion_assets/FreeCadAssets/wall_lateral_template.FCStd
218.0 x 3.00 x 82.0 mm
