DanielFLopez1620/orion_common/orion_assets/LasserAssets/com_plate.dxf

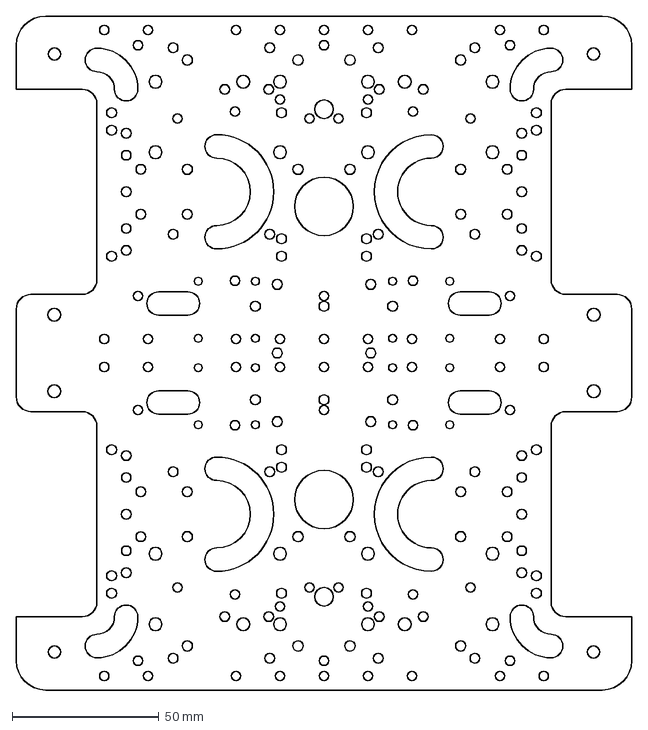
[picture p49: CAD file, 2025-11-06]
orion_assets/LasserAssets/com_plate.dxf
210.0 x 230.0 mm
