DanielFLopez1620/orion_common/orion_description/meshes/os30a.stl

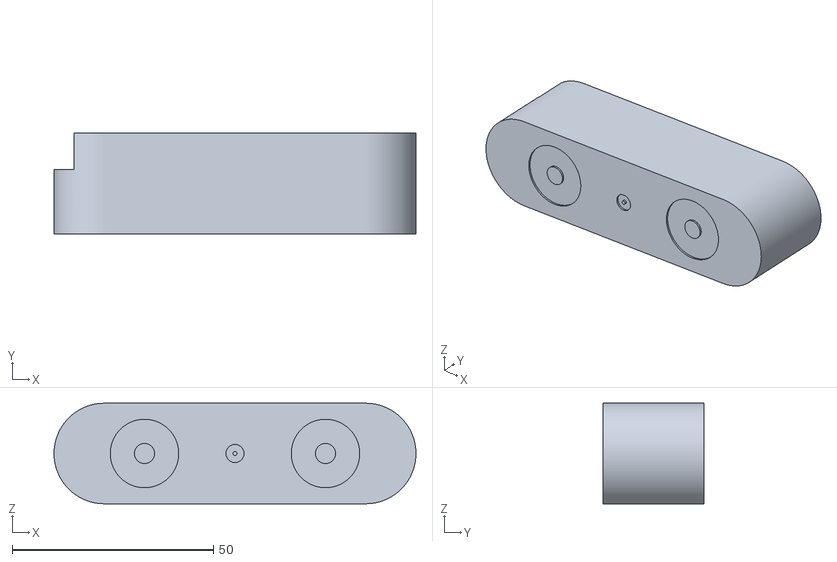
[picture p50: CAD file, 2025-11-06]
orion_description/meshes/os30a.stl
90.0 x 25.0 x 25.0
