DanielFLopez1620/orion_common/orion_assets/LasserAssets/half_plate_template.dxf

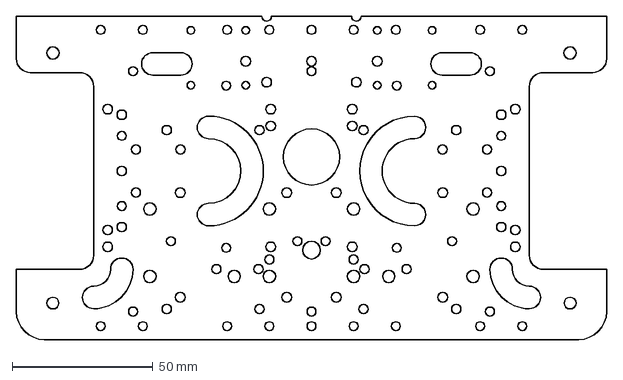
[picture p51: CAD file, 2025-11-06]
orion_assets/LasserAssets/half_plate_template.dxf
210.0 x 115.0 mm
