DanielFLopez1620/orion_common/orion_description/meshes/touch_sensor.stl

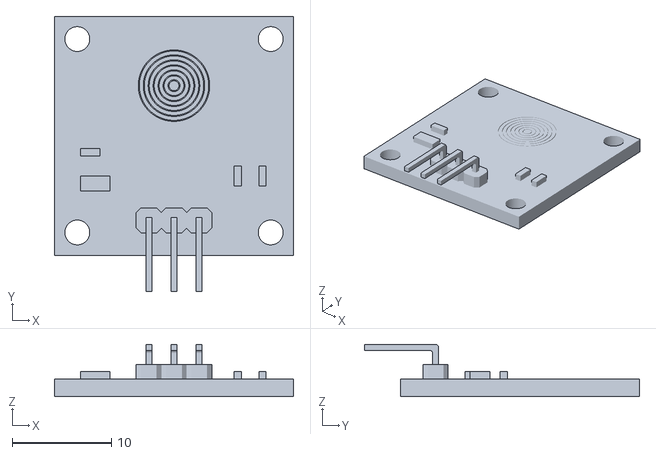
[picture p52: CAD file, 2025-11-06]
orion_description/meshes/touch_sensor.stl
24.1 x 27.8 x 5.25
