DanielFLopez1620/orion_common/orion_assets/FreeCadAssets/caster_wheel_p1.FCStd

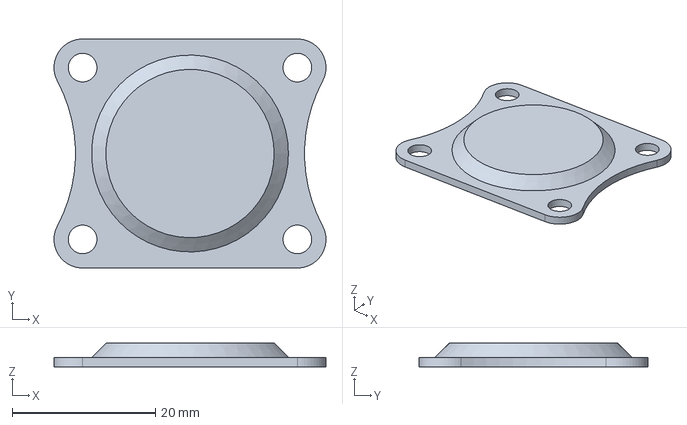
[picture p53: CAD file, 2026-07-29]
orion_assets/FreeCadAssets/caster_wheel_p1.FCStd
38.0 x 32.0 x 3.35 mm
