DanielFLopez1620/orion_common/orion_description/meshes/spacer_m4x17.stl

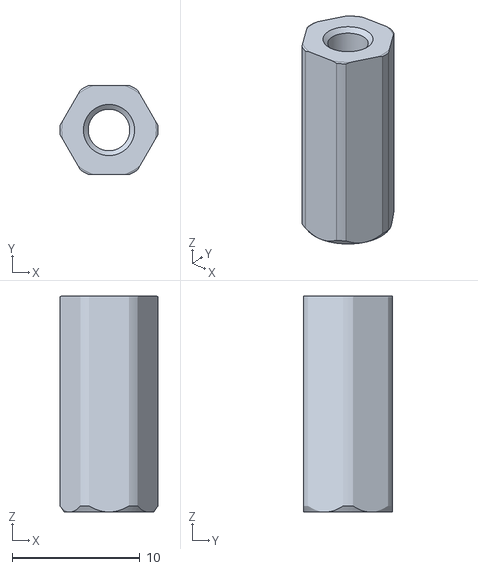
[picture p54: CAD file, 2025-11-06]
orion_description/meshes/spacer_m4x17.stl
7.68 x 7.00 x 16.9
