DanielFLopez1620/orion_common/orion_description/meshes/neumatic.stl

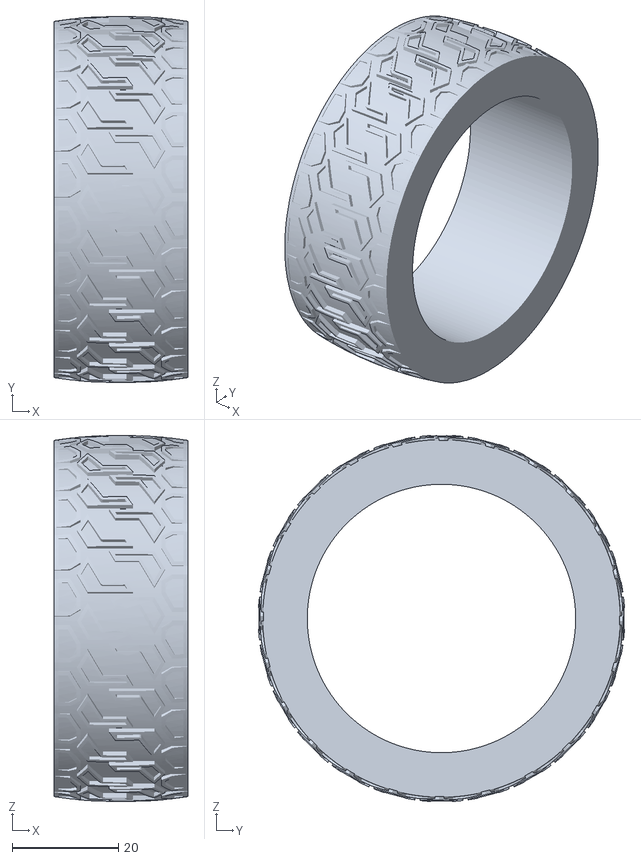
[picture p55: CAD file, 2025-11-06]
orion_description/meshes/neumatic.stl
25.1 x 68.9 x 68.9
