DanielFLopez1620/orion_common/orion_assets/FreeCadAssets/mini_speaker.FCStd

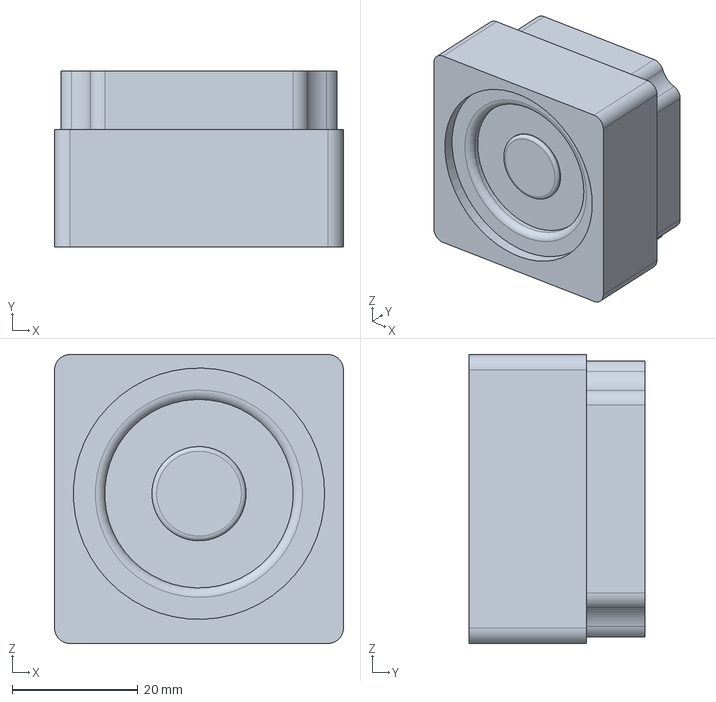
[picture p56: CAD file, 2026-07-29]
orion_assets/FreeCadAssets/mini_speaker.FCStd
46.0 x 28.0 x 46.0 mm
