DanielFLopez1620/orion_common/orion_description/meshes/bathold_support.stl

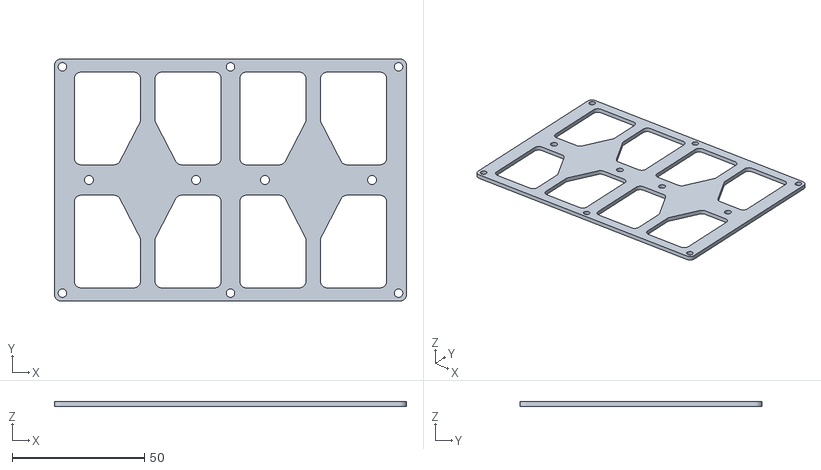
[picture p57: CAD file, 2025-11-06]
orion_description/meshes/bathold_support.stl
133.0 x 91.5 x 2.00
