DanielFLopez1620/orion_common/orion_description/meshes/astra_s.stl

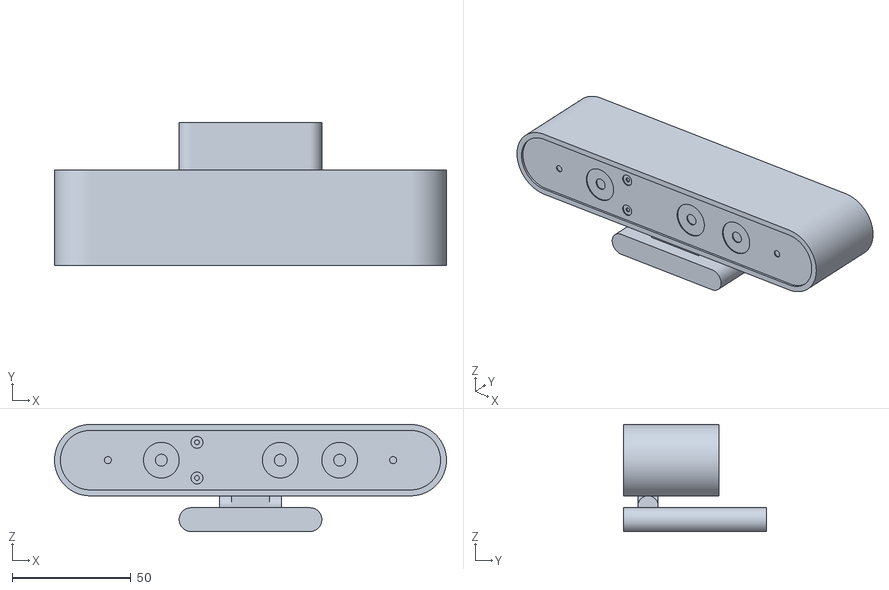
[picture p58: CAD file, 2025-11-06]
orion_description/meshes/astra_s.stl
164.8 x 60.0 x 45.0
