DanielFLopez1620/orion_common/orion_assets/FreeCadAssets/driver_l298.FCStd

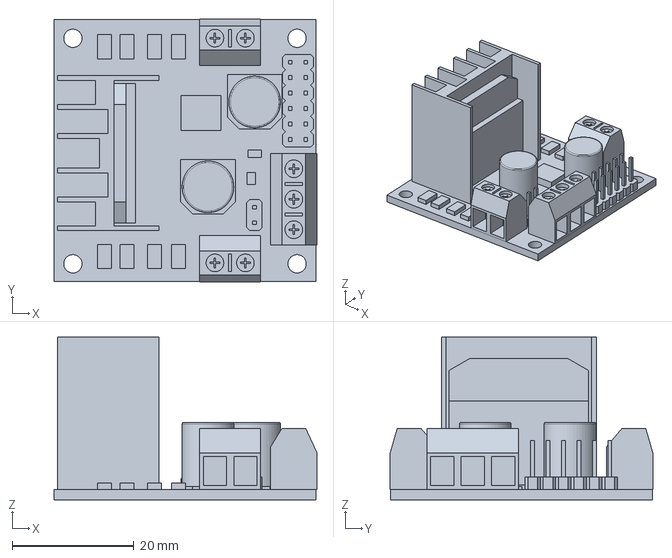
[picture p59: CAD file, 2026-07-29]
orion_assets/FreeCadAssets/driver_l298.FCStd
43.2 x 43.1 x 26.8 mm
