DanielFLopez1620/orion_common/orion_assets/FreeCadAssets/regulator_support.FCStd

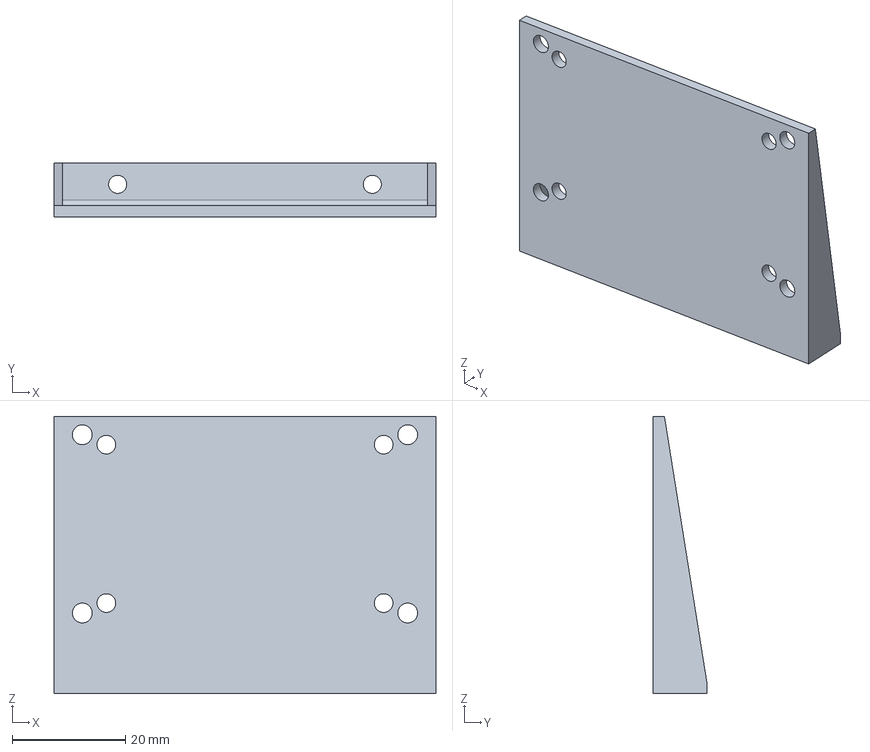
[picture p60: CAD file, 2026-07-29]
orion_assets/FreeCadAssets/regulator_support.FCStd
67.5 x 9.50 x 49.0 mm
