DanielFLopez1620/orion_common/orion_assets/FreeCadAssets/bms_186503s.FCStd

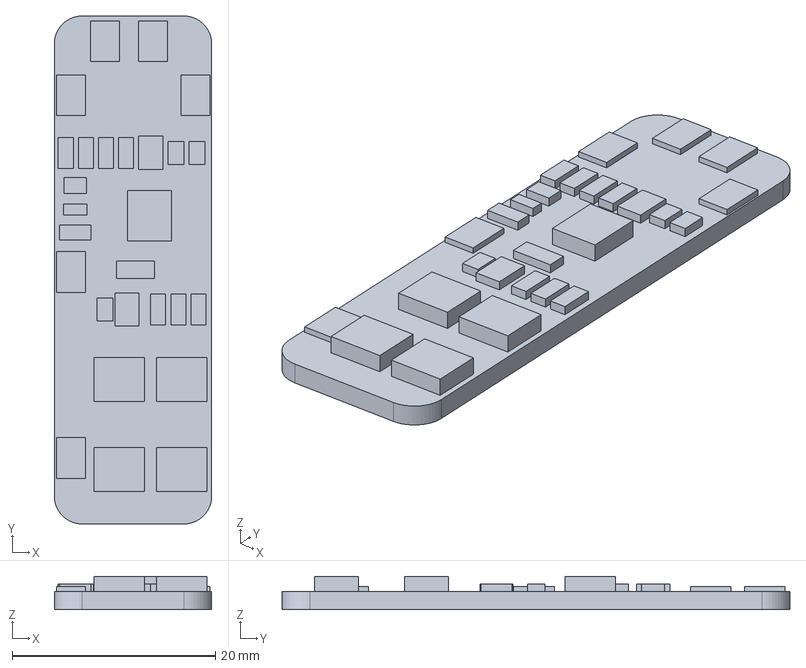
[picture p61: CAD file, 2026-07-29]
orion_assets/FreeCadAssets/bms_186503s.FCStd
15.5 x 50.0 x 3.25 mm
