DanielFLopez1620/orion_common/orion_description/meshes/caster_wheel.stl

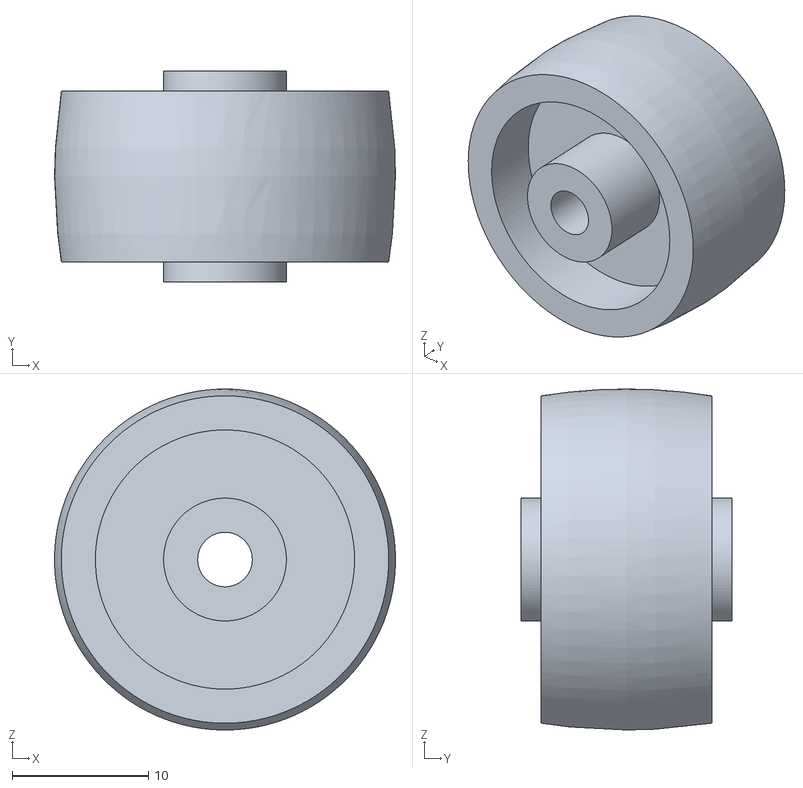
[picture p62: CAD file, 2025-11-06]
orion_description/meshes/caster_wheel.stl
25.0 x 15.5 x 25.0
