DanielFLopez1620/orion_common/orion_assets/FreeCadAssets/ld19_lidar.FCStd

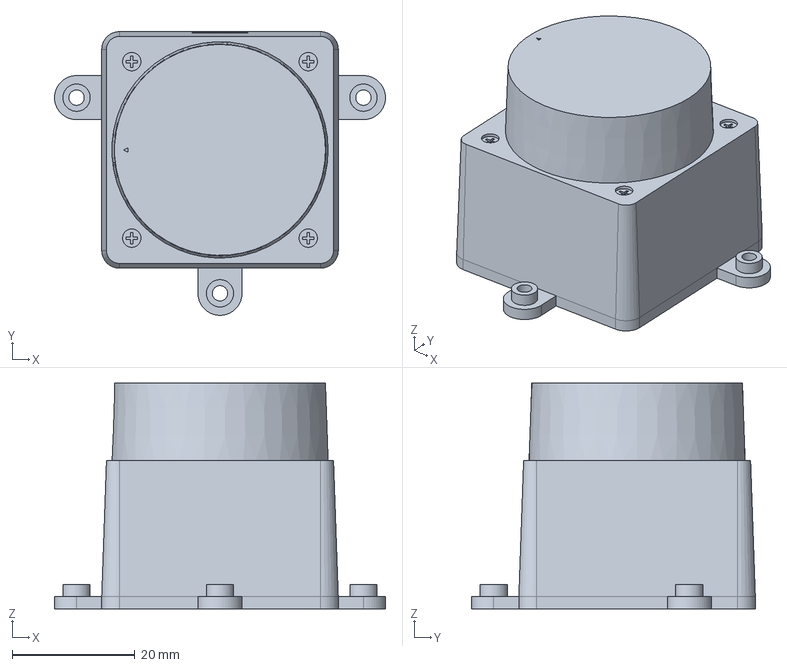
[picture p64: CAD file, 2026-07-29]
orion_assets/FreeCadAssets/ld19_lidar.FCStd
54.0 x 46.3 x 36.8 mm
