DanielFLopez1620/orion_common/orion_assets/FreeCadAssets/spacer_10x80.FCStd

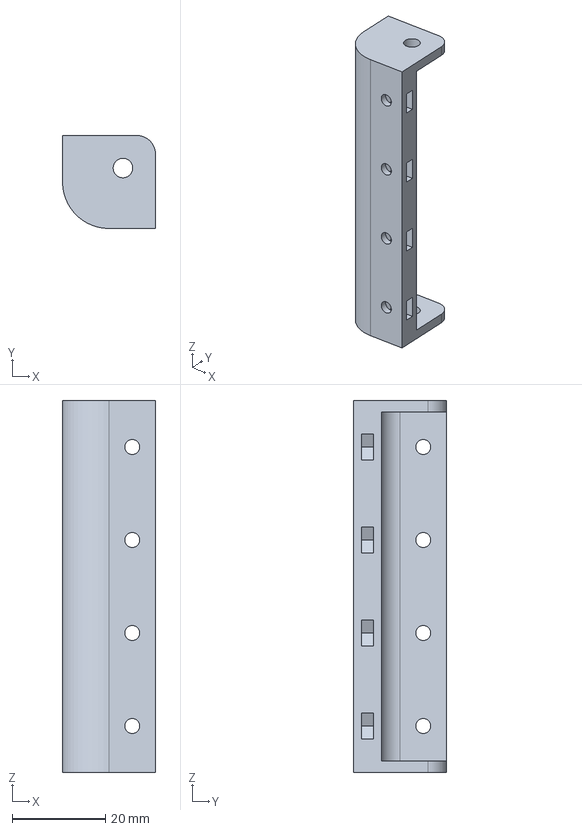
[picture p67: CAD file, 2026-07-29]
orion_assets/FreeCadAssets/spacer_10x80.FCStd
20.0 x 20.0 x 80.0 mm
