DanielFLopez1620/orion_common/orion_description/meshes/wall_screen.stl

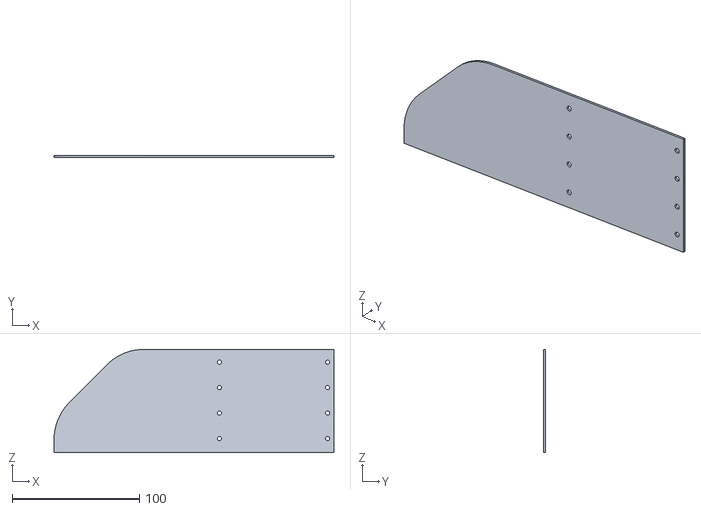
[picture p68: CAD file, 2025-11-06]
orion_description/meshes/wall_screen.stl
220.0 x 1.50 x 81.0
