DanielFLopez1620/orion_common/orion_assets/FreeCadAssets/screen_support.FCStd

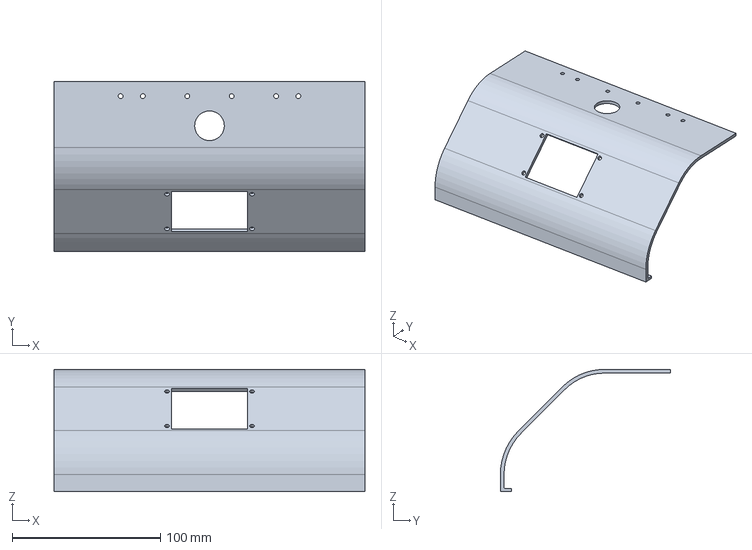
[picture p69: CAD file, 2026-07-29]
orion_assets/FreeCadAssets/screen_support.FCStd
210.0 x 115.0 x 82.5 mm
