DanielFLopez1620/orion_common/orion_description/meshes/wall_fdefault.stl

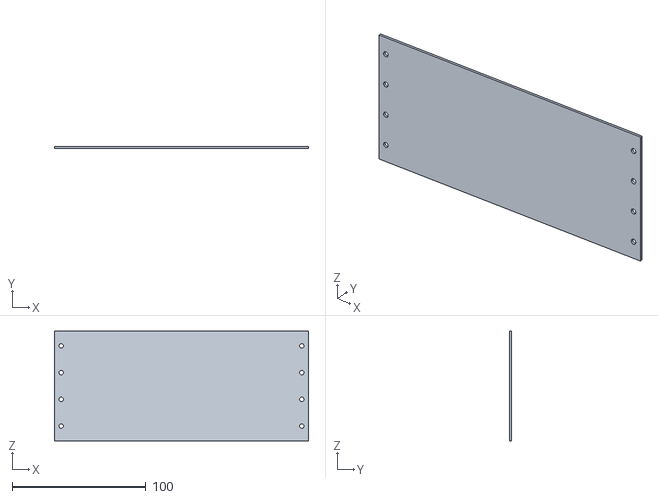
[picture p70: CAD file, 2025-11-06]
orion_description/meshes/wall_fdefault.stl
190.0 x 1.50 x 82.0
