DanielFLopez1620/orion_common/orion_assets/FreeCadAssets/regulator_2.FCStd

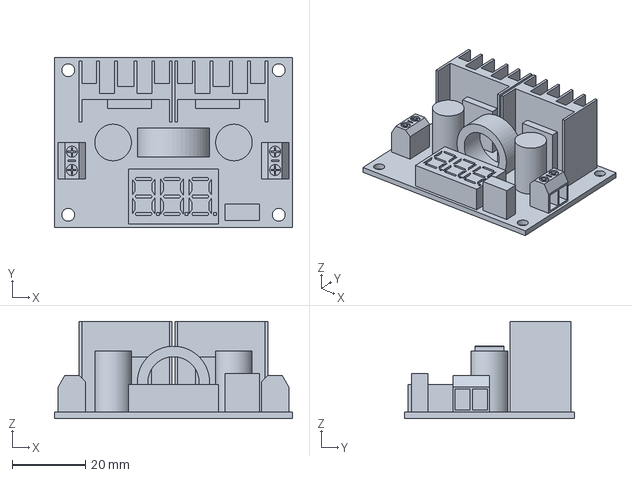
[picture p71: CAD file, 2026-07-29]
orion_assets/FreeCadAssets/regulator_2.FCStd
65.0 x 46.5 x 26.5 mm
