DanielFLopez1620/orion_common/orion_description/meshes/coupling.stl

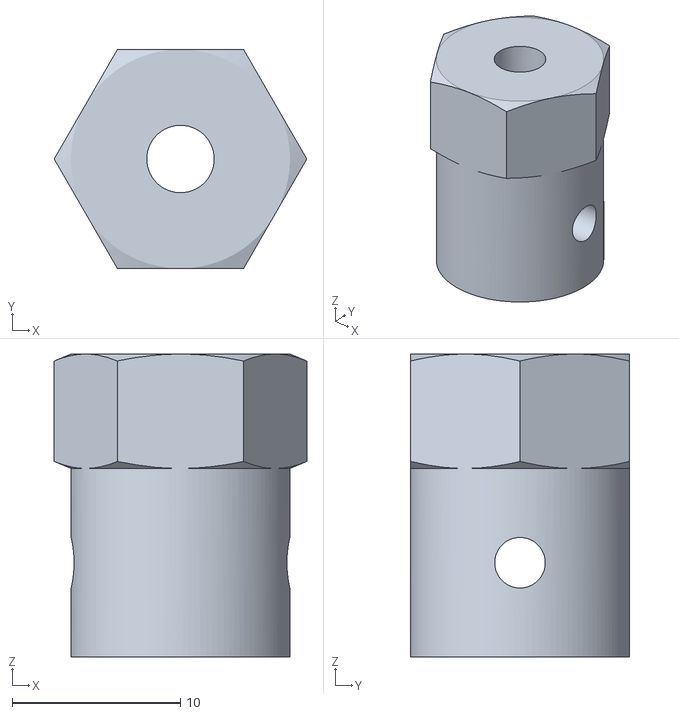
[picture p72: CAD file, 2025-11-06]
orion_description/meshes/coupling.stl
15.0 x 13.0 x 18.0
