DanielFLopez1620/orion_common/orion_description/meshes/ring.stl

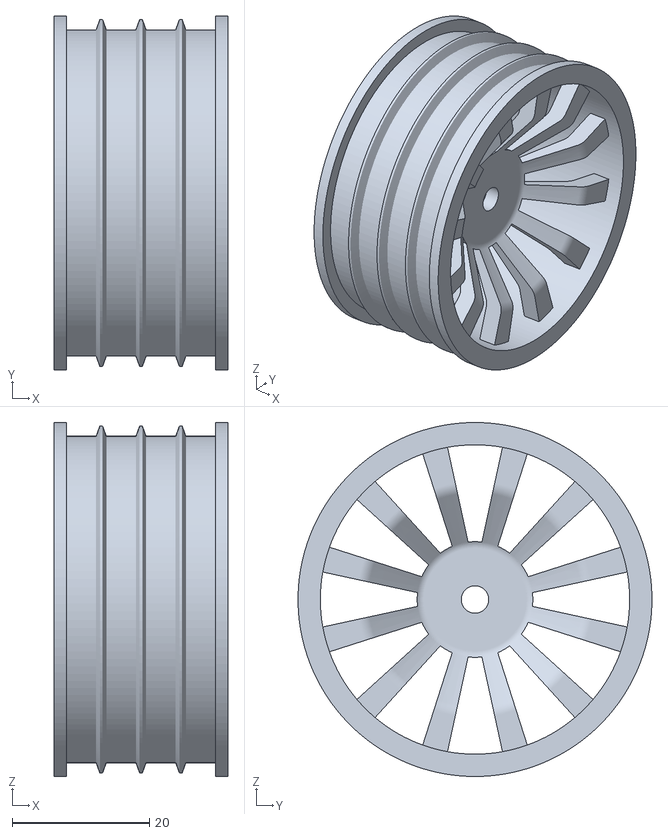
[picture p73: CAD file, 2025-11-06]
orion_description/meshes/ring.stl
25.2 x 51.5 x 51.5
