DanielFLopez1620/orion_common/orion_assets/FreeCadAssets/rpi5.FCStd

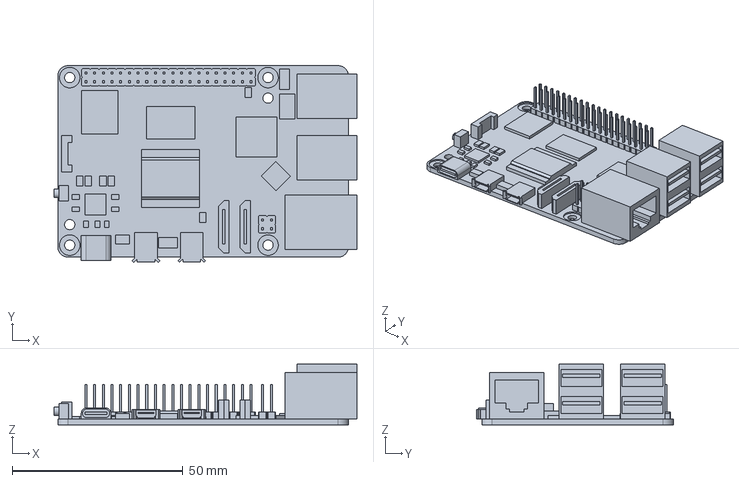
[picture p74: CAD file, 2026-07-29]
orion_assets/FreeCadAssets/rpi5.FCStd
88.6 x 57.5 x 17.8 mm
