DanielFLopez1620/orion_common/orion_assets/FreeCadAssets/microphone.FCStd

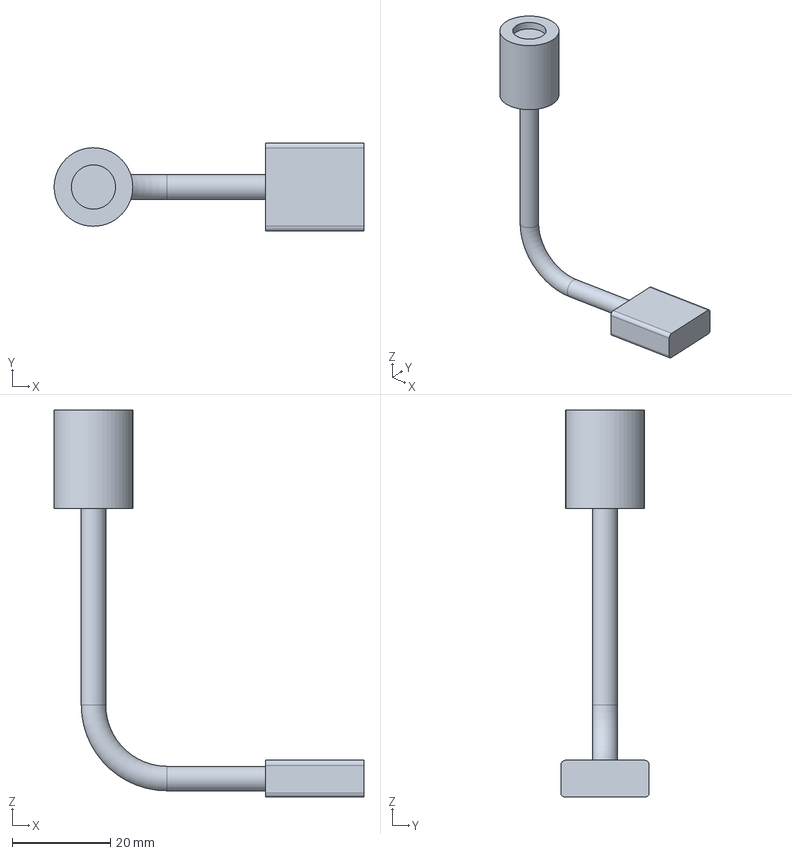
[picture p75: CAD file, 2026-07-29]
orion_assets/FreeCadAssets/microphone.FCStd
63.0 x 18.0 x 78.8 mm
