DanielFLopez1620/orion_common/orion_assets/FreeCadAssets/switch_3s_6a.FCStd

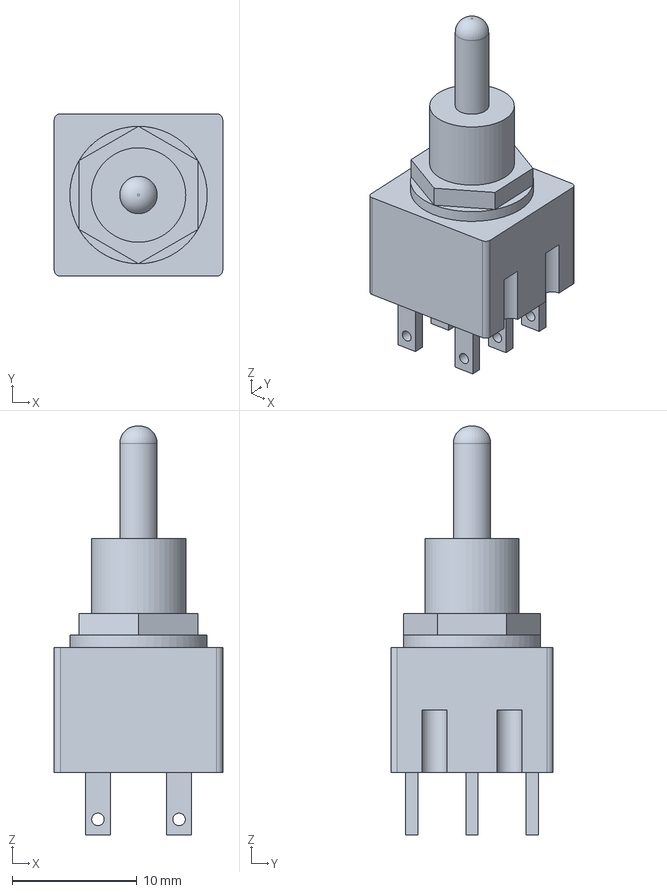
[picture p76: CAD file, 2026-07-29]
orion_assets/FreeCadAssets/switch_3s_6a.FCStd
13.5 x 13.0 x 32.8 mm
