DanielFLopez1620/orion_common/orion_description/meshes/wall_batteries.stl

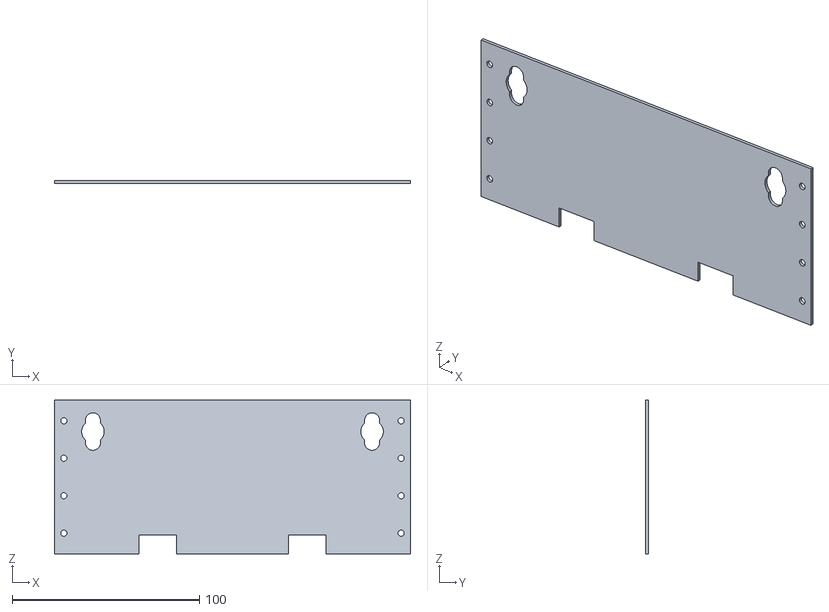
[picture p77: CAD file, 2025-11-06]
orion_description/meshes/wall_batteries.stl
190.0 x 1.50 x 82.0
