DanielFLopez1620/orion_common/orion_assets/FreeCadAssets/motor_mount.FCStd

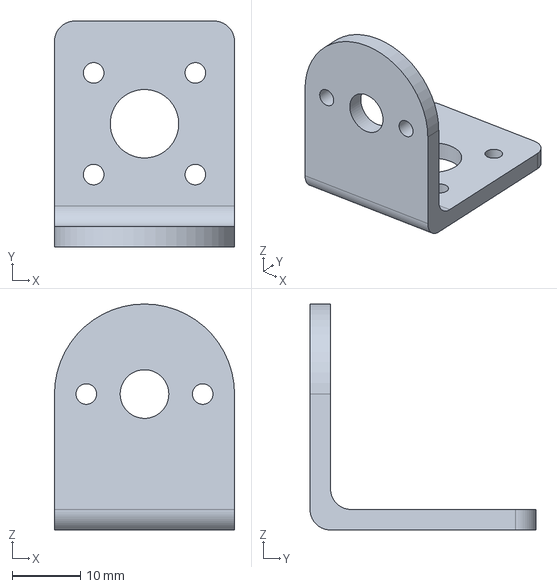
[picture p78: CAD file, 2026-07-29]
orion_assets/FreeCadAssets/motor_mount.FCStd
26.3 x 33.0 x 33.0 mm
