DanielFLopez1620/orion_common/orion_assets/FreeCadAssets/dc_motor_wenc.FCStd

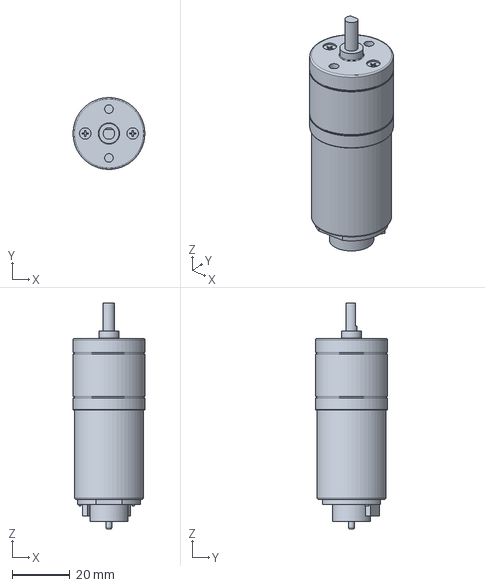
[picture p79: CAD file, 2026-07-29]
orion_assets/FreeCadAssets/dc_motor_wenc.FCStd
25.0 x 25.0 x 78.6 mm
