DanielFLopez1620/orion_common/orion_description/meshes/wall_ldefault.stl

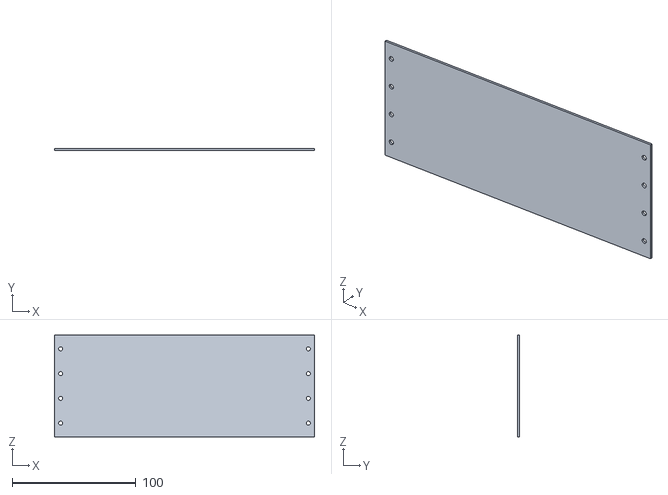
[picture p80: CAD file, 2025-11-06]
orion_description/meshes/wall_ldefault.stl
210.0 x 1.50 x 82.0
