DanielFLopez1620/orion_common/orion_assets/FreeCadAssets/wall_frontal_template.FCStd

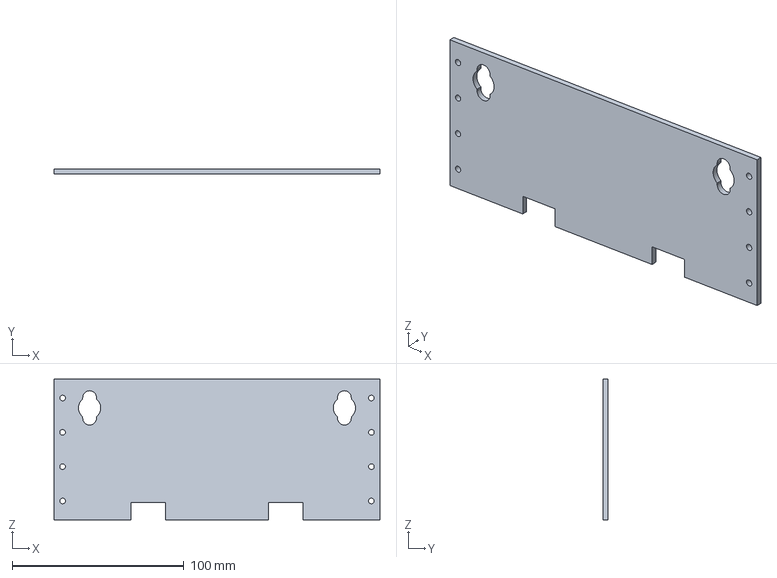
[picture p81: CAD file, 2026-07-29]
orion_assets/FreeCadAssets/wall_frontal_template.FCStd
190.0 x 3.00 x 82.0 mm
