DanielFLopez1620/orion_common/orion_assets/FreeCadAssets/maixsense_support.FCStd

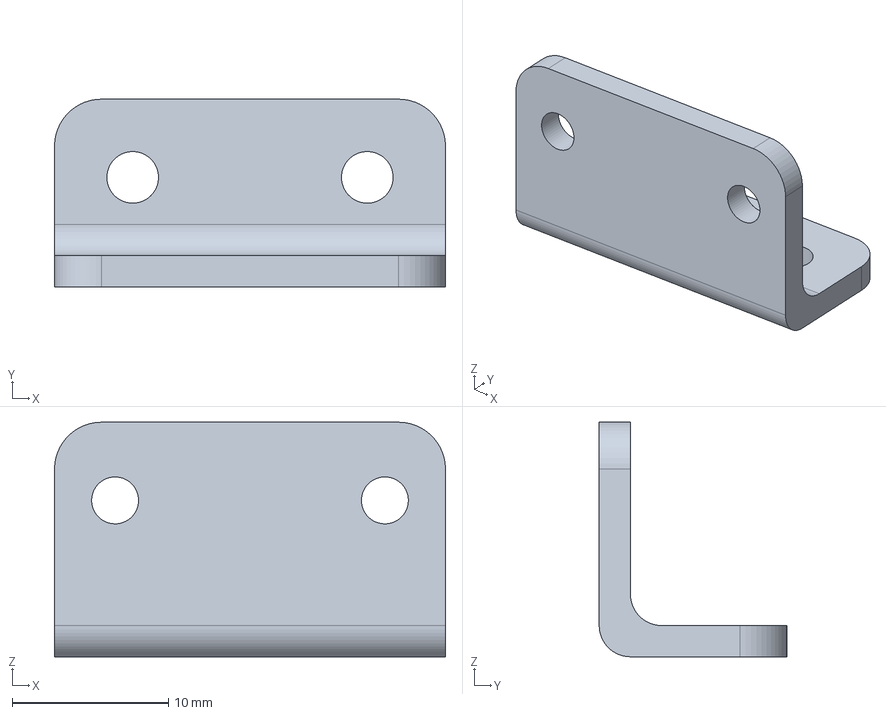
[picture p82: CAD file, 2026-07-29]
orion_assets/FreeCadAssets/maixsense_support.FCStd
25.0 x 12.0 x 15.0 mm
