DanielFLopez1620/orion_common/orion_assets/FreeCadAssets/servo_support.FCStd

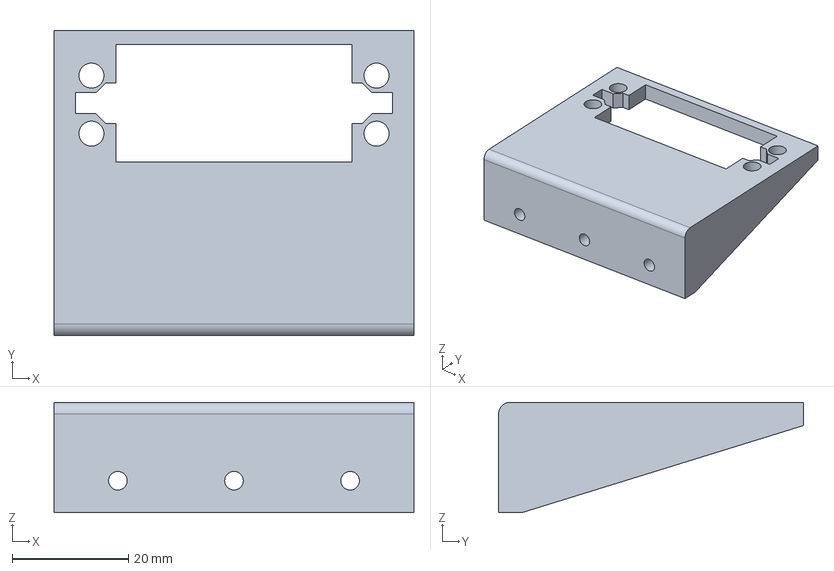
[picture p83: CAD file, 2026-07-29]
orion_assets/FreeCadAssets/servo_support.FCStd
62.0 x 52.5 x 19.0 mm
