DanielFLopez1620/orion_common/orion_assets/FreeCadAssets/rpi_4b_heatsinks.FCStd

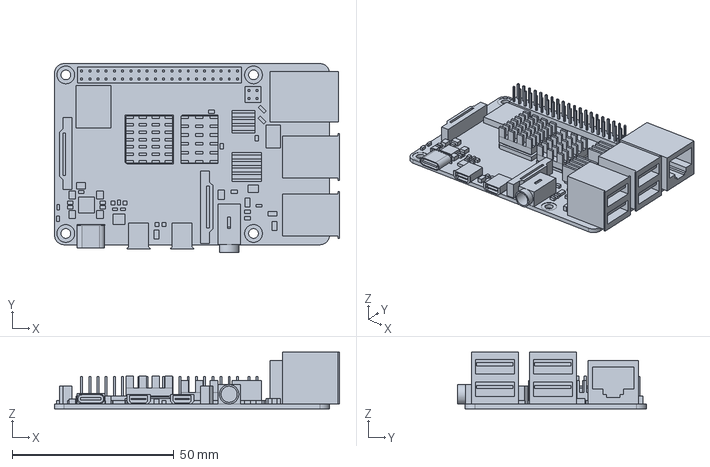
[picture p84: CAD file, 2026-07-29]
orion_assets/FreeCadAssets/rpi_4b_heatsinks.FCStd
88.1 x 58.4 x 17.5 mm
