DanielFLopez1620/orion_common/orion_description/meshes/caster_base.stl

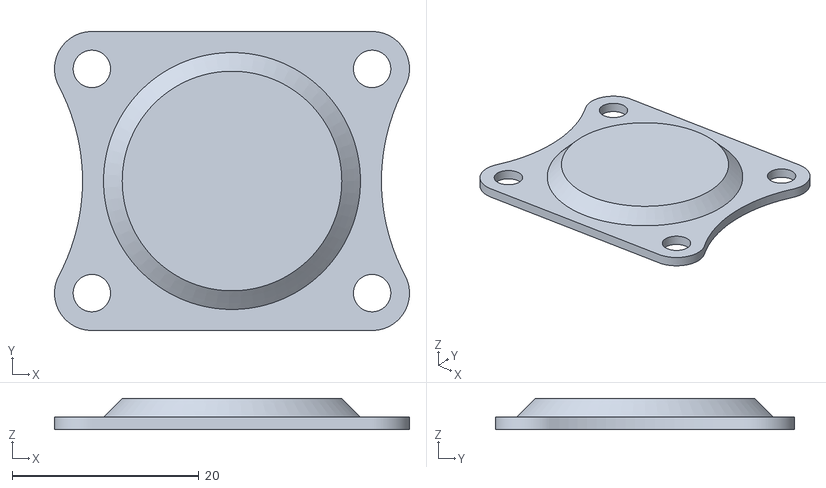
[picture p85: CAD file, 2025-11-06]
orion_description/meshes/caster_base.stl
38.0 x 32.0 x 3.35
