DanielFLopez1620/orion_common/orion_description/meshes/switch_3s_15a.stl

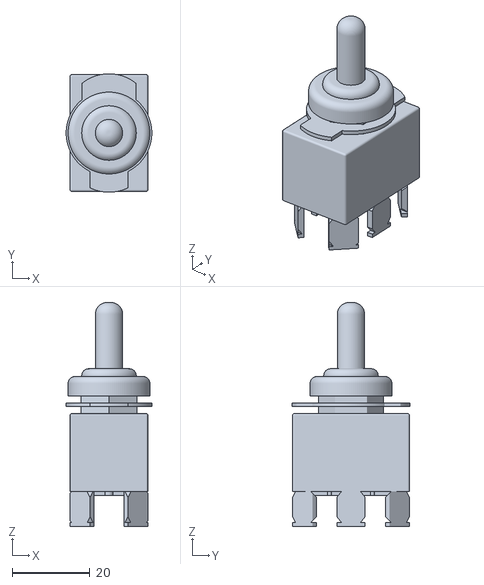
[picture p86: CAD file, 2025-11-06]
orion_description/meshes/switch_3s_15a.stl
22.0 x 30.4 x 57.5
