DanielFLopez1620/orion_common/orion_assets/FreeCadAssets/simple_arm.FCStd

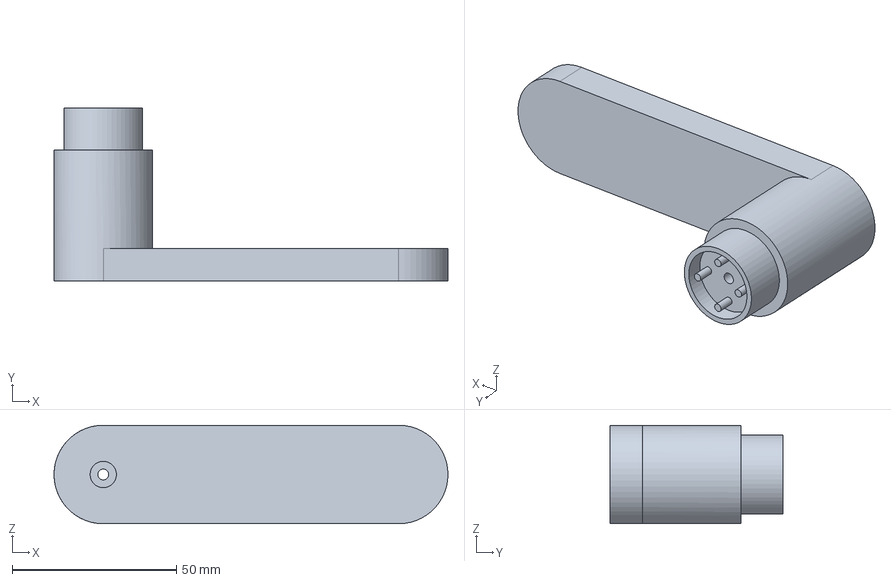
[picture p88: CAD file, 2026-07-29]
orion_assets/FreeCadAssets/simple_arm.FCStd
120.0 x 52.8 x 30.0 mm
