DanielFLopez1620/orion_common/orion_description/meshes/maixsense.stl

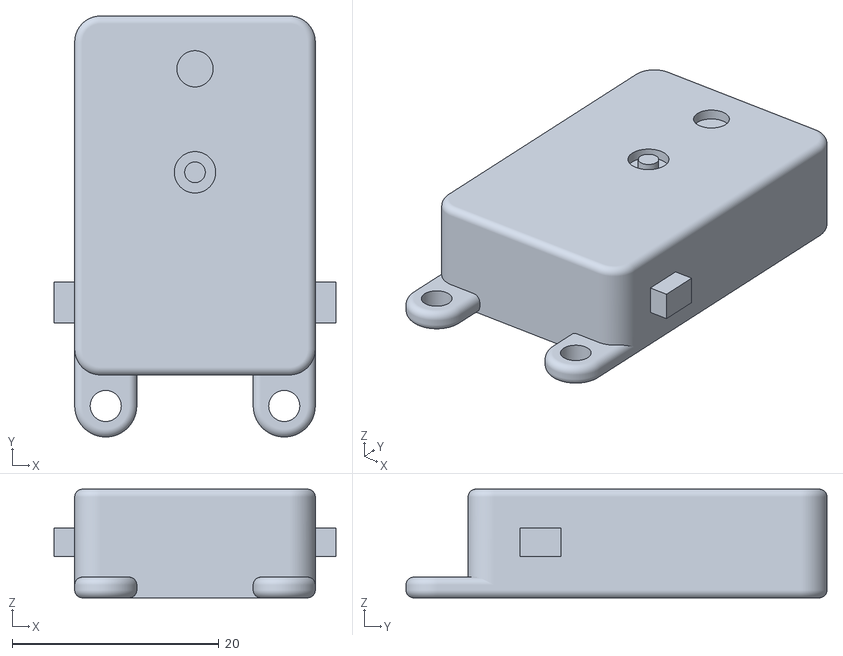
[picture p89: CAD file, 2025-11-06]
orion_description/meshes/maixsense.stl
27.2 x 40.7 x 10.5
