DanielFLopez1620/orion_common/orion_description/meshes/esp32_adp.stl

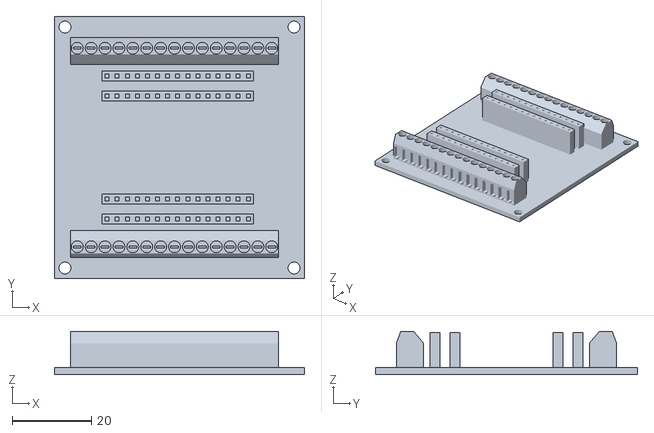
[picture p90: CAD file, 2025-11-06]
orion_description/meshes/esp32_adp.stl
63.0 x 66.0 x 10.9
