DanielFLopez1620/orion_common/orion_assets/FreeCadAssets/joint_plates_m4.FCStd

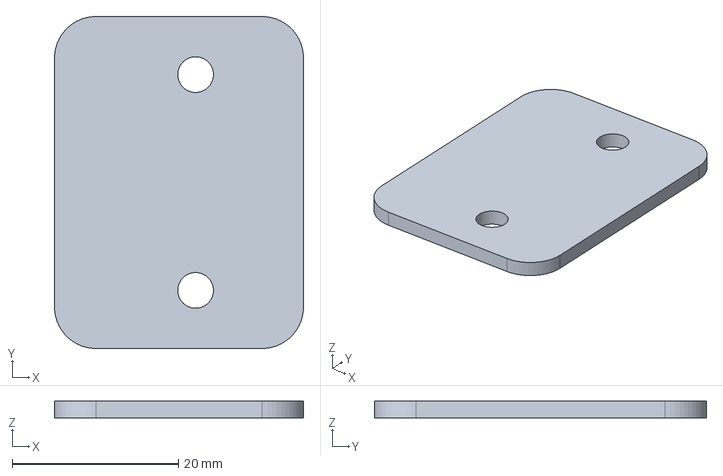
[picture p91: CAD file, 2026-07-29]
orion_assets/FreeCadAssets/joint_plates_m4.FCStd
30.0 x 40.0 x 2.00 mm
