DanielFLopez1620/orion_common/orion_description/meshes/wall_rpi.stl

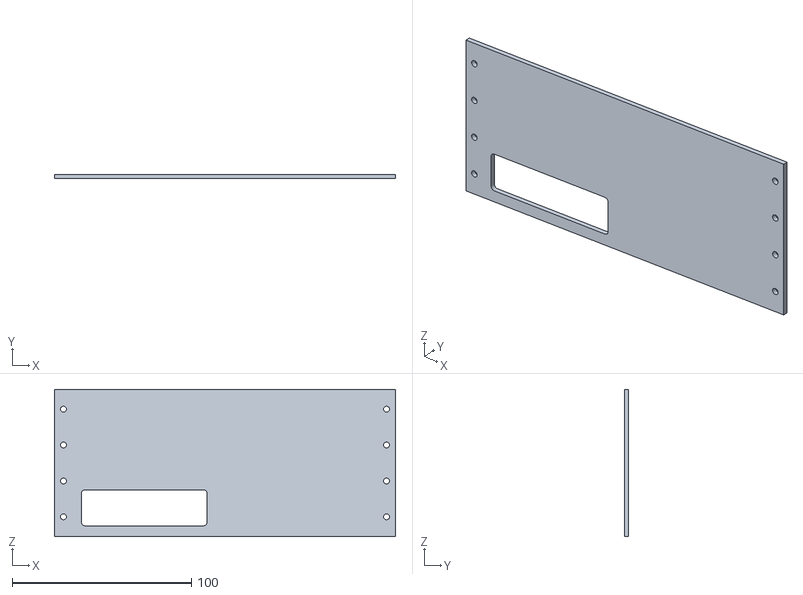
[picture p92: CAD file, 2025-11-06]
orion_description/meshes/wall_rpi.stl
190.0 x 2.50 x 82.0
