DanielFLopez1620/orion_common/orion_description/meshes/servo_sup.stl

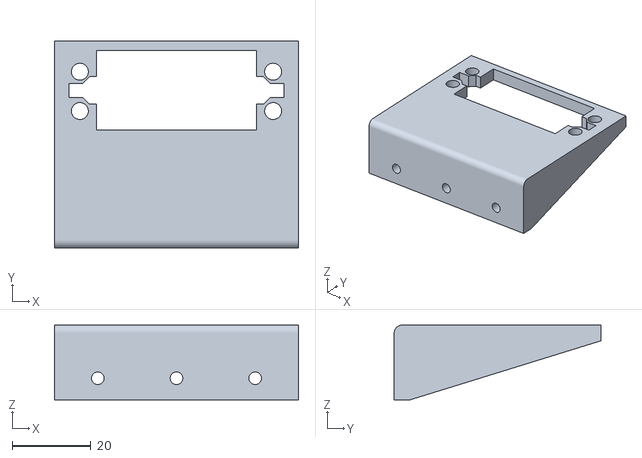
[picture p93: CAD file, 2025-11-06]
orion_description/meshes/servo_sup.stl
62.0 x 52.5 x 19.0
