DanielFLopez1620/orion_common/orion_description/meshes/wall_servo.stl

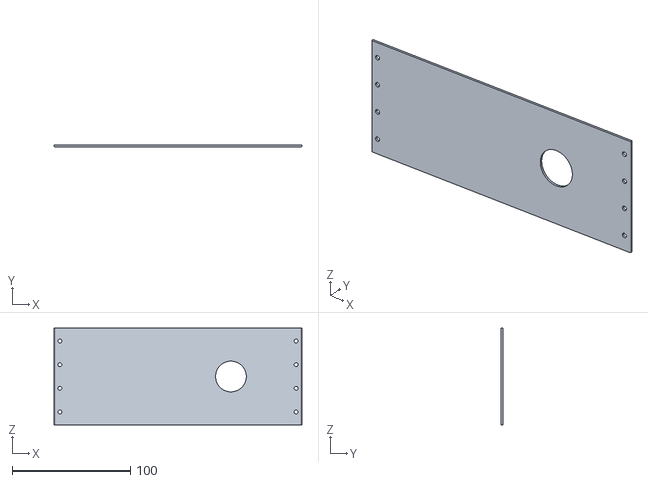
[picture p94: CAD file, 2025-11-06]
orion_description/meshes/wall_servo.stl
210.0 x 1.50 x 82.0
