DanielFLopez1620/orion_common/orion_description/meshes/wall_llidar.stl

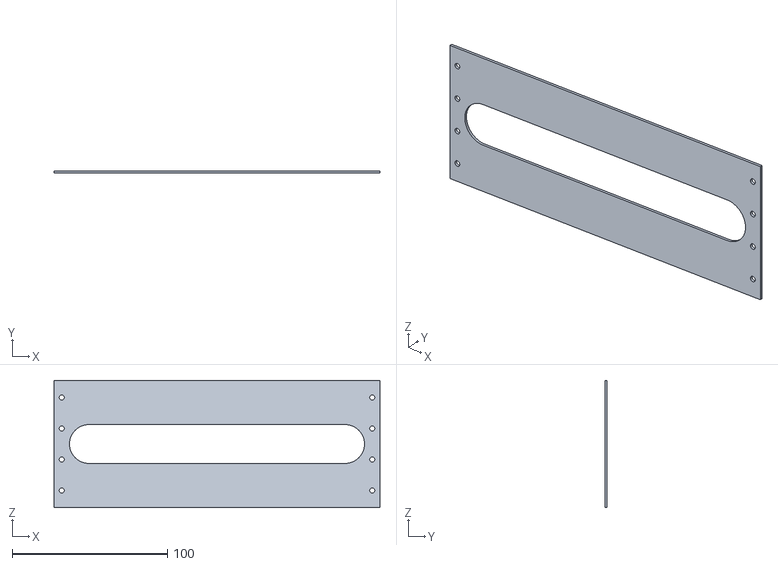
[picture p95: CAD file, 2025-11-06]
orion_description/meshes/wall_llidar.stl
210.0 x 1.50 x 82.0
