DanielFLopez1620/orion_common/orion_description/meshes/screen_sup.stl

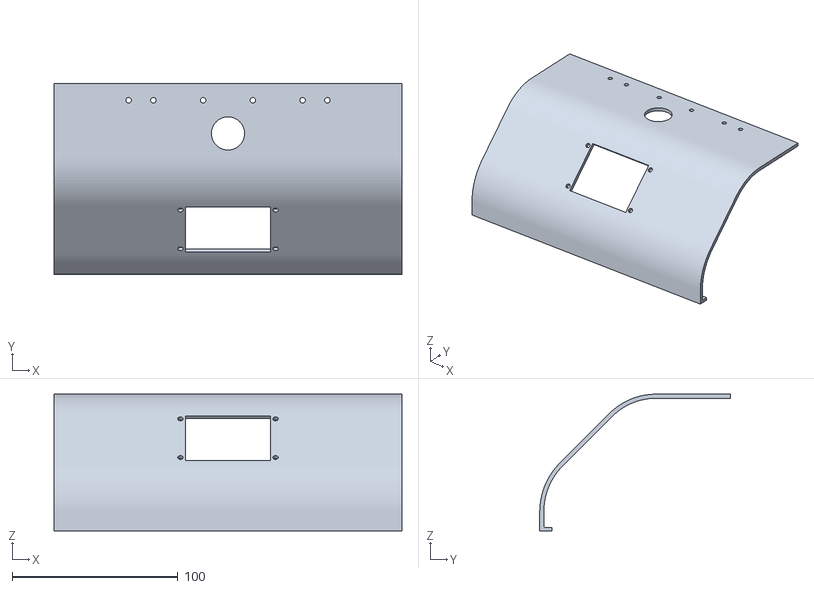
[picture p96: CAD file, 2025-11-06]
orion_description/meshes/screen_sup.stl
210.0 x 115.0 x 82.5
