DanielFLopez1620/orion_common/orion_description/meshes/spacer_m3x20.stl

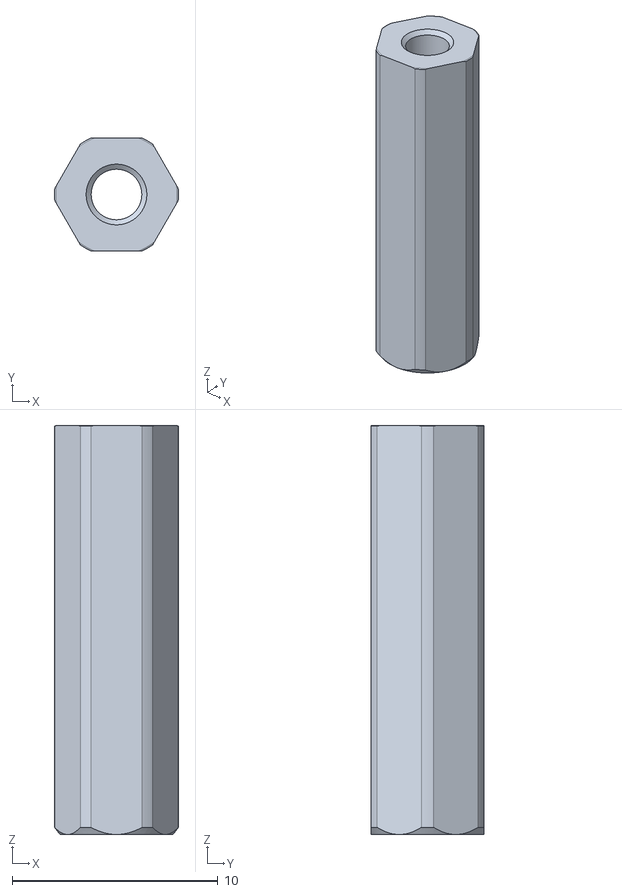
[picture p97: CAD file, 2025-11-06]
orion_description/meshes/spacer_m3x20.stl
6.03 x 5.50 x 19.9
