DanielFLopez1620/orion_common/(list of files, cad)

Other CAD files:
orion_assets/FreeCadAssets/speaker_support.FCStd
orion_assets/FreeCadAssets/spacer_m4x17.FCStd
orion_assets/FreeCadAssets/touch_sensor_prot.FCStd
orion_description/meshes/screen_il9225.stl
orion_description/meshes/speaker.stl
orion_assets/FreeCadAssets/batteryholderx3.FCStd
orion_assets/FreeCadAssets/joint_screen.FCStd
orion_assets/FreeCadAssets/serial_ld.FCStd
orion_description/meshes/speaker_stereo.stl
orion_assets/FreeCadAssets/touch_sensor.FCStd
orion_description/meshes/spacer_10x80.stl
orion_description/meshes/regulator_sup.stl
orion_description/meshes/mg996r.stl
orion_description/meshes/motor_mount.stl
orion_description/meshes/os30a_sup.stl
orion_assets/FreeCadAssets/ring.FCStd
orion_description/meshes/maixsense_sup.stl
orion_description/meshes/ld19.stl
orion_assets/FreeCadAssets/caster_wheel_p3.FCStd
orion_description/meshes/motor_dc.stl
orion_assets/FreeCadAssets/astra_s.FCStd
orion_assets/FreeCadAssets/neumatic.FCStd
orion_assets/FreeCadAssets/com_plate_template.FCStd
orion_description/meshes/caster_middle.stl
orion_assets/FreeCadAssets/coupling.FCStd
orion_description/meshes/simple_arm.stl
orion_assets/FreeCadAssets/servo_connection.FCStd
orion_description/meshes/driver.stl
orion_assets/FreeCadAssets/sipeed_a010.FCStd
orion_description/meshes/spacer_m3x10.stl
orion_assets/FreeCadAssets/bathold_support.FCStd
orion_description/meshes/rpi4.stl
orion_assets/FreeCadAssets/esp32_adapter.FCStd
orion_assets/FreeCadAssets/yd_os30a.FCStd
orion_description/meshes/esp32.stl
orion_description/meshes/rpi5.stl
orion_description/meshes/regulator_2.stl
orion_description/meshes/microphone.stl
orion_assets/3DPrintAssets/joint_plates_m3.stl
orion_assets/3DPrintAssets/joint_plates_m4.stl
orion_assets/3DPrintAssets/joint_screen.stl
orion_assets/3DPrintAssets/servo_connection_ext.stl
orion_assets/3DPrintAssets/simple_arm.stl
orion_assets/FreeCadAssets/b18650.FCStd
orion_description/meshes/b18650.stl
orion_description/meshes/bms186503s.stl
