DanielFLopez1620/orion_common/orion_bringup/README.md

# 🤖 ORION Bringup

## 🌟 Overview

This repository contains the bringup and startup of the ORION robot. Before using this package, do not forget to upload the codes on the two ESP32 on [orion_base](/orion_base/README.md)

---

## 📝 License

The source code is released under a [BSD 3-Clause license](/orion_bringup/LICENSE.md).

**Author**: Daniel Felipe López Escobar.

The ORION Commons packages have been tested under [ROS](https://www.ros.org/) **Jazzy** distribution.

---

## 📚 Table of Contents

- [📝 Udev rules set up](#-udev-rules-set-up)
- [🚀 Launch files](#-launch-files)
- [🚀 Setup of bringup on Startup](#-setup-of-bringup-on-startup)
- [⚠️ Troubleshooting](#️-troubleshooting)
  - [Astra S compilation](#astra-s-compilation)
  - [Startup service not loading](#startup-service-not-loading)
  - [Robot is not moving](#robot-is-not-moving)
  - [Pi Camera not publishing](#pi-camera-ov5647-not-publishing-with-g_movtrue)
  - [LiDAR not loading](#lidar-not-loading-libldlidarso-cannot-open-shared-object-file)
  - [CycloneDDS type hash warnings](#cyclonedds-type-hash-warnings)
  - [Controller RT scheduling warning](#controller-manager-real-time-scheduling-warning)

---

## 📝 Udev rules set up

As we are using multiple USB devices which may change of port or even the USB devices may be different, for example, depending on your cameras selection. This is the reason we require to implement **udev** rules.

### General considerations

Begin by connecting each device (only one at a time) and reading its attributes:

~~~bash
ls /dev | grep USB
# With the USB device found use
udevadm info --name=/dev/ttyUSB0 --attribute-walk
~~~

A good start is to focus on the attributes like **idVendor**, **idProduct**, **serial** and **product**. If you do not find them, you can use **grep**.

~~~bash
udevadm info --name=/dev/ttyUSB0 --attribute-walk | grep idVendor
~~~

In case you note the attributes selected repeat with others, search for others. And as last resource, you can use environmental attributes, like the **ID_PATH**, this is not always recommended as if the connections change it will be different later.

~~~bash
udevadm info --name=/dev/ttyUSB0 --attribute-walk | grep ID_PATH
~~~

Once you have decided the attributes and elements, you can create a file for these rules and add the content:

~~~bash
sudo nano /etc/udev/rules.d/99-usb-serial.rules
~~~

~~~bash
# Inside of the rules file
SUBSYSTEM=="tty", ATTRS{idVendor}=="10c4", ATTRS{idProduct}=="ea60", ATTRS{serial}=="0001", SYMLINK+="ttyESP32_1"

~~~

A demo file you can use to replicate your rules is [example_udev.rules](/orion_bringup/example_udev.rules):

~~~rules
# LD19 LIDAR (youyeetoo LD19) — match by vendor/product/serial
SUBSYSTEM=="tty", ATTRS{idVendor}=="10c4", ATTRS{idProduct}=="ea60", ATTRS{serial}=="0001", MODE:="0666", SYMLINK+="ttyLD19"

# ESP32 boards — use ID_PATH to distinguish two boards from the same batch
SUBSYSTEM=="tty", ENV{ID_PATH}=="platform-fd500000.pcie-pci-0000:01:00.0-usb-0:1.3.1:1.0", MODE:="0666", SYMLINK+="ttyESP32_1"
SUBSYSTEM=="tty", ENV{ID_PATH}=="platform-fd500000.pcie-pci-0000:01:00.0-usb-0:1.3.3:1.0", MODE:="0666", SYMLINK+="ttyESP32_2"

# MaixSense A010 — exposes two interfaces; bind by kernel name + interface number
SUBSYSTEM=="tty", KERNELS=="1-1.2:1.0", ATTRS{bInterfaceNumber}=="00", MODE:="0666", SYMLINK+="ttyA010"
SUBSYSTEM=="tty", KERNELS=="1-1.2:1.1", ATTRS{bInterfaceNumber}=="01", MODE:="0666", SYMLINK+="ttyA010_debug"

# Orbbec Astra S (USB device)
SUBSYSTEM=="usb", ATTR{idProduct}=="0402", ATTR{idVendor}=="2bc5", MODE:="0666", OWNER:="root", GROUP:="video", SYMLINK+="astra_s"
~~~

### Comments based on components

- **LD19:** Its rules were based on the [ldrobot-lidar-ros2](https://github.com/Myzhar/ldrobot-lidar-ros2/blob/devel/rules/ldlidar.rules) package of Myzhar. This apply for the youyeetoo LD19 LIDAR and worked on 3 different LIDARs. However, do not forget to validate the attributes.

- **ORBBEC Astra S:** Its rules were taken from [depth_orbbec_astra](https://github.com/Tesis-ORION/depth_orbbec_astra/blob/main/orbbec_camera/scripts/99-obsensor-libusb.rules) repository.

- **MaixSense A010:** when connecting this device, you may notice it gives two USB devices, one for the device itself and another one for debugging, keep this in mind when using the rules as you may get a duplicated device.

- **OS30A:** As a note, you do not need rules for the OS30A, as it is configured to use its serial in the launch files for the camera.

- **ESP32:** As there are two ESP32 and there is a high probability you bought the two ESP32 from the same batch, they may end with the same attributes. That is the reason, you should prefer a environmental attribute like the **ID_PATH** to distinguish both devices.

    Also make sure that the ESP32 of the first floor is the one with the name **/dev/ttyESP32_1** and the one in the fourth floor is the **/dev/ttyESP32_2**, as the PlatformIO and µ-ROS programs will use this ports by default.

    For more information on the ESP32 and the udev rules, check [orion_base](/orion_base/README.md).

## 🚀 Launch files

### bringup.launch.py

The [bringup.launch.py](/orion_bringup/launch/bringup.launch.py) file will take charge of initializing the robot on the Raspberry PI, so it can load the description, camera drivers, controllers and µ-ROS nodes so the robot have full functionalities. It can be added to a startup service to be ready.

~~~bash
# Basic usage:
# ros2 launch orion_bringup bringup.launch.py
# Additional arguments:
#   camera : Can be 'a010' or 'os30a'.
#   g_mov : Boolean (true/false) to use g_mov module when using 'a010' depth cam.
#           When true, also launches the OV5647 Pi Camera (camera_ros) and the
#           MPU6050 IMU node. Requires host-level setup — see docs/cam/README.md.
#   rasp : Whether to use 'rpi4' or 'rpi5', this will imply a change in the sound hardware.
#   servo : Boolean (true/false) to indicate if use servo arms
#   ros2_control : Boolean (true/false) to indicate usage of ros2_controllers
#   simplified : Boolean (true/false) to indicate if use the simplified URDF model
#   ctl_type: Control type can be 'micro_ros' or 'serial'.
#   motor : Motor rpms to select your motor params (for now, '100' or '1000')
#   calibrate_imu : Boolean (true/false, g_mov only) force IMU re-calibration.
ros2 launch orion_bringup bringup.launch.py camera:=a010
~~~

## 🚀 Setup of bringup on Startup

You can enable the robot's bringup launch in order to start as the Raspberry Pi is being initialized, for this case, we will use services and actions for **systemd**.

### 📋 Prerequisites

1. **Ubuntu/Linux-based OS** installed on the Raspberry Pi (tested with Ubuntu 24.04).

2. **ROS2 Jazzy** installed and sourced correctly. A minimal install (`ros-jazzy-ros-base`) is often missing several packages that ORION requires. Install them explicitly:

    ~~~bash
    sudo apt install -y \
        ros-jazzy-ros2-control \
        ros-jazzy-ros2-controllers \
        ros-jazzy-controller-manager \
        ros-jazzy-joint-state-broadcaster \
        ros-jazzy-diff-drive-controller \
        ros-jazzy-forward-command-controller \
        python3-colcon-common-extensions
    ~~~

3. **micro-ROS agent** installed. The agent bridges the ESP32 µ-ROS nodes to ROS 2. Install it from the pre-built binary:

    ~~~bash
    sudo snap install micro-ros-agent
    ~~~

    Or build it from source if the snap is unavailable on your architecture:

    ~~~bash
    mkdir -p ~/microros_ws/src && cd ~/microros_ws
    git clone -b jazzy https://github.com/micro-ROS/micro_ros_setup.git src/micro_ros_setup
    source /opt/ros/jazzy/setup.bash
    colcon build --packages-select micro_ros_setup
    source install/setup.bash
    ros2 run micro_ros_setup create_agent_ws.sh
    ros2 run micro_ros_setup build_agent.sh
    ~~~

4. **Hardware PWM enabled** (required for arm servos via MG996R). Add the overlay and export the PWM channel:

    ~~~bash
    # Add to /boot/firmware/config.txt (once, then reboot)
    echo "dtoverlay=pwm,gpiopin=12,func=4" | sudo tee -a /boot/firmware/config.txt
    sudo reboot
    ~~~

    After reboot, export the PWM channel so the servo node can access it without root:

    ~~~bash
    echo 0 | sudo tee /sys/class/pwm/pwmchip0/export
    sudo chmod -R a+rw /sys/class/pwm/pwmchip0/
    ~~~

    > ⚠️ The `chmod` must be re-applied after every boot. Add it to `/etc/rc.local` or a systemd `ExecStartPre` if you want it persistent. For Docker, `setup_host.sh` installs `pwm-setup.service` which handles this automatically.

5. ROS2 workspace (e.g., `ros2_ws`) built and sourced.

6. Devices are connected: both ESP32s, your selected camera (OS30A, A010, ASTRA_S), the LIDAR LD19, speakers, and microphone.

7. You have set up the **udev** rules.

### 📁 File Structure

Ensure you have the following elements:

1. You have a valid ROS 2 workspace:

    ~~~bash
    cd ~/ros2_ws/src
    ~~~

2. Add the content of the [startup_robot.sh](/orion_bringup/startup_robot.sh) to your local bin directory:

    ~~~bash
    sudo nano /usr/local/bin/startup_robot.sh
    ~~~

    Do not forget to check that the script works before proceeding:

    ~~~sh
    #!/bin/bash
    set -e

    G_MOV="true"        # Options: true, false
    CAMERA_TYPE="a010"  # Options: a010, astra_s, os30a
    echo "Selected camera: $CAMERA_TYPE"

    echo "Waiting for internet connection..."
    while ! ping -c 1 8.8.8.8 &>/dev/null; do sleep 1; done
    echo "Internet connection established."

    for DEV in /dev/ttyESP32_1 /dev/ttyESP32_2 /dev/ttyLD19; do
        echo "Waiting for $DEV..."
        while [ ! -e "$DEV" ]; do sleep 1; done
        echo "$DEV found."
    done

    if [ "$CAMERA_TYPE" == "a010" ]; then
        while [ ! -e /dev/ttyA010 ]; do sleep 1; done
        echo "/dev/ttyA010 is available."
    elif [ "$CAMERA_TYPE" == "astra_s" ]; then
        while ! lsusb | grep -i "astra_s" &>/dev/null; do sleep 1; done
        echo "Astra S USB device found."
    fi

    echo "Sourcing ROS2 and workspace..."
    source /opt/ros/jazzy/setup.bash
    source ~/ros2_ws/install/setup.bash

    echo "Launching ORION bringup..."
    ros2 launch orion_bringup bringup.launch.py camera:=$CAMERA_TYPE g_mov:=$G_MOV
    ~~~

3. Install the PWM setup service [pwm-setup.service](/orion_bringup/pwm-setup.service). This exports the hardware PWM channel and sets permissions so the servo node can access it without root:

    ~~~bash
    sudo cp orion_bringup/pwm-setup.service /etc/systemd/system/pwm-setup.service
    sudo systemctl daemon-reload
    sudo systemctl enable --now pwm-setup.service
    ~~~

    > This must run before `startup_robot.service`. The dependency is declared in `startup_robot.service` via `Requires=pwm-setup.service`.

4. Add the service [startup_robot.service](/orion_bringup/startup_robot.service) to the systemd directory:

    ~~~bash
    sudo nano /etc/systemd/system/startup_robot.service
    ~~~

    Copy the content from [startup_robot.service](/orion_bringup/startup_robot.service) and **change `User`, `Environment HOME`, and `WorkingDirectory`** to match your actual username:

    ~~~service
    [Unit]
    Description=Startup ROS2 Bringup Service
    After=network-online.target pwm-setup.service
    Wants=network-online.target
    Requires=pwm-setup.service

    [Service]
    ExecStart=/usr/local/bin/startup_robot.sh
    User=YOUR_USERNAME
    Environment=HOME=/home/YOUR_USERNAME
    WorkingDirectory=/home/YOUR_USERNAME
    Restart=on-failure
    StandardOutput=journal
    StandardError=journal

    [Install]
    WantedBy=multi-user.target
    ~~~

### 🛠️ Step-by-Step Setup

1. Give permission to the startup script:

    ~~~bash
    sudo chmod +x /usr/local/bin/startup_robot.sh
    ~~~

    Do not forget to update the script if your user, camera type, or device names change.

2. Reload **systemd** and enable both services:

    ~~~bash
    sudo systemctl daemon-reload
    sudo systemctl enable pwm-setup.service
    sudo systemctl enable startup_robot.service
    ~~~

    To start immediately without rebooting:

    ~~~bash
    sudo systemctl start pwm-setup.service
    sudo systemctl start startup_robot.service
    ~~~

3. Verify the Service Status (do this after launching it manually and at the robot startup)

    ~~~bash
    systemctl status startup_robot.service
    ~~~

4. View Service Logs and check everything is ok:

    ~~~bash
    journalctl -u startup_robot.service
    ~~~

    For real-time logs:

    ~~~bash
    journalctl -u startup_robot.service -f
    ~~~

---

### 🧪 Testing the Setup

1. **Reboot** the Raspberry Pi:

    ~~~bash
    sudo reboot
    ~~~

2. Confirm the service starts correctly using:

    ~~~bash
    systemctl status startup_robot.service
    ~~~

    or by checking logs:

    ~~~bash
    journalctl -u startup_robot.service -b
    ~~~

3. Also, open a terminal inside the Pi, and review the topics:

    ~~~bash
    ros2 topic list
    # It should display the description, control and µ-ROS topics
    ~~~

## ⚠️ Troubleshooting

### Astra S compilation

The [Astra S Camera Package](https://github.com/Tesis-ORION/depth_orbbec_astra) may have problems compiling on RPi 4 with 4 GB of RAM or less, so by default the Astra S options have been disabled on the [bringup.launch.py](/orion_bringup/launch/bringup.launch.py), [CMakeLists.txt](/orion_bringup/CMakeLists.txt) and [package.xml](/orion_bringup/package.xml). So, check the comments and enable the options if you want to use the Astra S camera.

### Startup service not loading

This may occur for the next reasons:

- The robot isn't connected to the internet, make sure to have a valid network for the ROS 2 communication

- One (or several) of the USB devices (ESP32, cameras or LIDAR) isn't connected and the startup service is waiting for the connection.

- The USB devices permissions didn't work, check them with:

    ~~~bash
    ls -al /dev | grep USB
    ~~~

    Use chmod on the device that no longer has read/write permissions.

    ~~~bash
    sudo chmod 777 /dev/ttyLD19
    sudo chmod 666 /dev/ttyUSB0
    ~~~

    Also, do not forget to add the user to the **dialout**.

### Robot is not moving

This may be caused if the µ-ROS nodes didn't activate on time or the connection with the agent wasn't possible. For this, just reboot the ESP32 by taking out the respective walls.

For more information check [orion_base](/orion_base/README.md)

### Pi Camera (OV5647) not publishing with `g_mov:=true`

The Pi Camera is launched only when `g_mov:=true` and requires host-level setup that cannot live inside the Docker container. If `/g_mov/image_raw` is not published, verify the following:

1. **Boot config** — `/boot/firmware/config.txt` must contain:

    ~~~text
    camera_auto_detect=0
    dtoverlay=ov5647
    ~~~

    These lines are added automatically by `orion_docker/robot/setup_host.sh`. Reboot after editing.

2. **libcamera (RPi fork)** — the apt version is incompatible. The RPi fork must be built from source and installed to `/usr/local`. See `docs/cam/README.md` Steps 2–5.

3. **camera_ros workspace** — must be built on the host at `~/picam_ws` against the RPi fork:

    ~~~bash
    ls ~/picam_ws/install/setup.bash
    ~~~

    If the file is missing, follow `docs/cam/README.md` Step 8.

4. **dma_heap permissions** — the user must belong to the `video` group and the rule `/etc/udev/rules.d/99-dma-heap.rules` must exist. Both are configured by `setup_host.sh`. Verify with:

    ~~~bash
    groups $USER | grep video
    cat /etc/udev/rules.d/99-dma-heap.rules
    ~~~

### LiDAR not loading (`libldlidar.so: cannot open shared object file`)

If the log shows:

~~~text
Failed to load library: dlopen error: libldlidar.so: cannot open shared object file
~~~

and the `lifecycle_manager` keeps printing `Waiting for service ldlidar_node/get_state`, the SDK shared library is missing from the container's install directory. This happens because the upstream `ldrobot-lidar-ros2` package moved its SDK to a git submodule in May 2026 and does not install `libldlidar.so` as part of its CMake install targets.

The fix is already applied in the robot Dockerfile: the submodule is initialized after `vcs import`, and `libldlidar.so` is copied to the install directory before the build artifacts are removed. Rebuild the container image to apply the fix:

~~~bash
docker build -t orion_robot:latest -f orion_docker/robot/Dockerfile .
~~~

### CycloneDDS type hash warnings

Warnings like the following are **expected and harmless**:

~~~text
[WARN] [rmw_cyclonedds_cpp]: Failed to parse type hash for topic 'rt/diff_ctl_motor_cmd' ... from USER_DATA '(null)'.
~~~

They appear because micro-ROS (ESP32) does not embed the RIHS01 type hash in the DDS `USER_DATA` QoS field, which CycloneDDS in Jazzy expects for type-safe discovery. Communication is not affected — topics are published and received correctly. The same warnings appear on any PC running RViz2 on the same ROS domain, as it sees the same ESP32-originated topics on the network.

### Controller manager real-time scheduling warning

If the log shows:

~~~text
[WARN] [controller_manager]: Could not enable FIFO RT scheduling policy: with error number <1>(Operation not permitted).
~~~

This means the `ros2_control_node` cannot use SCHED_FIFO real-time scheduling. When running inside Docker as a non-root user, this requires the `--ulimit rtprio=99` and `--ulimit memlock=-1` flags on the `docker run` command. Both are included in the service generated by `setup_host.sh`. Re-run `setup_host.sh` and restart the service if you see this warning after updating the Docker setup:

~~~bash
sudo systemctl daemon-reload
sudo systemctl restart orion_robot.service
~~~
