DanielFLopez1620/orion_common/orion_bringup/config/ldlidar.yaml

# config/ldlidar.yaml
#
# Example configuration file to configure a `ldlidar_node`

/**:
  ros__parameters:
    general:
      debug_mode: false # true to activate debug messages

    comm:
      serial_port: '/dev/ttyLD19' # serial port name
      baudrate: 230400 # serial baudrate for LDLiDAR_LD19: 230400. Serial baudrate for LDLiDAR_STL27L: 921600
      timeout_msec: 1000 # data communication timeout in msec

    lidar:
      model: 'LD19' # Model type: 'LD06', 'LD19' (upstream v0.3.0+ dropped the LDLiDAR_ prefix)
      rot_verse: 'CCW' # 'CW' -> `CLOCKWISE` / 'CCW' -> `COUNTERCLOCKWISE` [ROS STANDARD]
      units: 'M' # 'MM' -> `MILLIMETERS` / 'CM' -> `CENTIMETERS` / 'M' -> `METERS` [ROS STANDARD]
      frame_id: 'laser_scan' # TF frame name for the lidar
      bins: 455 # set to 0 for dynamic scan size according to rotation speed, set to a fixed value [e.g. 455] for compatibility with SLAM Toolbox
      range_min: 0.03 # Minimum distance in 'units'
      range_max: 15.0 # Maximum distance in 'units'
      enable_angle_crop: false # enable angle cropping
      angle_crop_min: 90.0 # minimum angle for cropping
      angle_crop_max: 270.0 # maximum angle for cropping
