DanielFLopez1620/orion_common/orion_control/src/servo.cpp

#include <cmath>
#include "orion_control/servo.hpp"

namespace orion_control
{
    void Servo::Setup(const std::string& joint_name)
    {
        this->joint_name_ = joint_name;
    }

} // orion_control
