DanielFLopez1620/orion_common/(commit log)

2025-06-16 Base: Updated emotion and screen management | Control: Changed Hz
    [g_mov_servo_controller.yaml, gz_ros_control.yaml, mobile_base_controller.yaml, simple_left_arm_controller.yaml, simple_right_arm_controller.yaml]
2025-09-29 Control: Modifying controllers of forward for servos | Util CPP: Added bdrige for servo data
2025-09-30 Control: Trying to link shared resource but still failing | Util CPP: Trying to access resource but failing
    [diffdrive_orion.cpp, diffdrive_orion.hpp, forward_orion.cpp, forward_orion.hpp]
2025-10-02 Control: Fixing mistype on urdf param lecture
    [diffdrive_orion.cpp]
2025-10-02 Base: Fixing Rate of controller | Control: Fixing rate on publishers
    [diffdrive_orion.hpp, forward_orion.hpp, main.cpp]
2025-10-23 Base: Fixing µ-ROS times and added blink face | Bringup: Chaning ros launch
    [main.cpp]
2025-11-04 Utils: Adding a sequence to try the emotions along with servo movements
2025-11-05 Base: Fixing startup noise that produces unexpected motor movement
    [main.cpp]
2025-11-06 Base: Fixing error on cmd_motor and updating safe startup
    [main.cpp]
2025-11-06 General: Improving format, adding docs nodes and completing missing dependencies
    [g_mov_servo_controller.yaml, gz_ros_control.yaml, mobile_base_controller.yaml, simple_left_arm_controller.yaml, simple_right_arm_controller.yaml]
2025-11-12 Assets: Updated walls of robot | Description: Updated macro for colors
    [orion_arms.urdf.xacro, orion_base.urdf.xacro, orion_macros.urdf.xacro, orion_materials.urdf.xacro, wall_batteries.FCStd, wall_curve.FCStd, wall_curve_speaker.FCStd, wall_flidar.FCStd]
2026-03-26 Base: Changing integers of PID to floats to fix controller behavior
    [main.cpp]
2026-04-09 Base: Reevaluation of the clamping implementation
2026-04-14 Docker: Fixing dependencies related with camera drivers and missing dpenednecies
2026-04-15 Control: Fxiing silent bug of overwriting of a pointer on the left wheel
    [diffdrive_orion.hpp]
2026-04-16 Base: Updated arms subs and deadzone of dc motors | Control: Fixed max velocity
    [mobile_base_controller.yaml]
2026-04-18 Base: Updating PID values, to start proportional only euristic experimentation
2026-04-19 Control: Fixing update time | Base: New PID params after euristic review
    [diffdrive_orion.hpp]
2026-04-19 Base: Updating PID response to 0 value, and incremienting Kp constant to consider deadzone effect
2026-04-20 Base: Restructing reset of PID to prevent motor noise on 0 and updating PID constants
    [main.cpp]
2026-04-25 Docker: Adding missing repository for LIDAR | BringUp: Adding dependency for LdComponent
2026-04-27 Base: Fix servo orientation | Control: Updating params | Utils: Adding pending node
    [mobile_base_controller.yaml, orion.urdf.xacro, orion_ros2_control.urdf.xacro]
2026-04-27 Bringup: Updated dependencies and startup | Control: Fixed typpos on methos Begin and bridge info
    [diffdrive_orion.cpp, forward_orion.cpp, wheel.hpp]
2026-04-27 Docs: Update gitignore | Base: Main fixes on usage for micro-ros | Docker: Updated branch for ldrobot
    [diffdrive_orion.hpp, hi_human.py, main.cpp]
2026-05-07 Base: Improving format of embedded software for controlling actuators
2026-05-07 Assets: Removing uneccesary assets and make adapts for generic ones
    [com_plate_template.FCStd, half_plate_template.FCStd, screen_support.FCStd, screen_support_h1.FCStd, screen_support_h2.FCStd, wall_batteries.FCStd, wall_curve.FCStd, wall_curve_speaker.FCStd]
2026-05-08 Assets: Rebuilding assembly, updating colors and fixing walls
    [assembly_orion.FCStd, com_plate_template.FCStd, maixsense_support.FCStd, screen_support.FCStd, simple_arm.FCStd, spacer_10x80.FCStd, wall_frontal_template.FCStd, wall_lateral_template.FCStd]
2026-05-08 Base, Bringup, control & utils: Improving format and comments
    [gz_ros_control.yaml, simple_left_arm_controller.yaml, simple_right_arm_controller.yaml]
2026-05-11 Description: Improving URDF notes and fixing typos
    [mobile_base_controller.yaml, orion.urdf.xacro, orion_arms.urdf.xacro, orion_base.urdf.xacro, orion_cameras.urdf.xacro, orion_macros.urdf.xacro, orion_materials.urdf.xacro, orion_ros2_control.urdf.xacro]
2026-05-11 Description: Replacing color and gz friction with macros, clearning macro files and updating comments
    [orion.urdf.xacro, orion_arms.urdf.xacro, orion_base.urdf.xacro, orion_macros.urdf.xacro, orion_materials.urdf.xacro, orion_ros2_control.urdf.xacro, regulator.stl]
2026-05-11 Assets: Updating ORION partial assembly | Control/Description: Updating servo connector name
    [assembly_orion.FCStd, orion_macros.urdf.xacro, orion_ros2_control.urdf.xacro, simple_left_arm_controller.yaml, simple_right_arm_controller.yaml, spacer_10x80.FCStd]
2026-05-12 Description: Adding meshes and xacro for g_mov as it is no longer maintained, updated camera links
    [accel.stl, accel_base.stl, orion.urdf.xacro, orion_cameras.urdf.xacro, orion_g_mov.urdf.xacro, orion_macros.urdf.xacro, picam.stl, picam_sup.stl]
2026-05-12 Description: Updating g_mov module | Utils Py: Adding accelerometer and servo scripts | Bringup: Updating controller call for g_mov servo
    [orion_ros2_control.urdf.xacro]
2026-05-13 Bringup: Adding g_mov components | Docker: Fixing i2c missing group
2026-05-15 Utils Py: Adding mpu calibration | Bringup: Adding condition to execute mpu calibration | Docker: Updating startup service
2026-05-15 Utils Py: Removing lgpio as the PWM contains a lot of noise, and passing to direct mangamenet of GPIO files
    [g_mov_servo_node.py]
2026-05-15 Docker: Removing lgpio and reorganzing gpio mangamenet for PWM
2026-05-16 Utils CPP & Python: Extending filtering zones on the robot LiDAR
2026-05-16 Bringup: Adding camera_ros node | Docker: Adding libcmaera and camera_ros configuration | Docs: Updating notes on the cam
2026-05-19 Docker: Updating management of LD Lidar Repo after upstream changed submodule usage | Cams: Updating camera_ros workspace for rpi
2026-05-20 Bringup: Updating LiDAR yaml and call of calibration | Docker: Fixing entrypoint and real time arg
    [ldlidar.yaml]
2026-05-20 Utils CPP and Python: Updating laser filter
2026-05-26 Utils CPP and Python: Including script for using the touch sensors of ORION
2026-05-29 ORION: Updating meta package info | Assets: Updating READMEs and file links | Base: Updating comments and notes on ESP32 programs | Bringup: Adding touch interaction node and updated README
    [assembly_orion_full.FCStd]
2026-06-01 General: Updating formatting and comments on codes, review of modifications
    [g_mov_servo_controller.yaml, mobile_base_controller.yaml, orion.urdf.xacro, orion_base.urdf.xacro]
2026-06-01 Assets: Updating FreeCAD assets to version 1.1.1
    [assembly_orion_full.FCStd, astra_s.FCStd, b18650.FCStd, bathold_support.FCStd, batteryholderx3.FCStd, bms_186503s.FCStd, caster_wheel_p1.FCStd, caster_wheel_p2.FCStd]
2026-07-29 Bringup: Adding pwm service | Utils: Ensuring servo pwm
