DanielFLopez1620/orion_common/(notices)

Notices in the files:
orion_assets/LasserAssets/wall_curve_speaker.dxf:
CC0
